shevapato2008/saiboard/conductor/index.md

# Project Context

## Definition
- [Product Definition](./product.md)
- [Product Guidelines](./product-guidelines.md)
- [Tech Stack](./tech-stack.md)

## Workflow
- [Workflow](./workflow.md)
- [Code Style Guides](./code_styleguides/)

## Management
- [Tracks Registry](./tracks.md)
- [Tracks Directory](./tracks/)
