shevapato2008/saiboard/conductor/tracks.md

# Project Tracks

This file tracks all major tracks for the project. Each track has its own detailed plan in its respective folder.

---

- [~] **Track: Phase 1 - Development Environment Setup and Hardware-Software Bridge Verification**
  *Link: [./tracks/setup_bridge_20260116/](./tracks/setup_bridge_20260116/)*
