shevapato2008/saiboard/docs/esp32-s3-led-matrix.md

# ESP32-S3 与 WS2812 矩阵接线与开发指南

## 1. ESP32-S3 介绍

### 1.1 组件说明（基于实物图）
- **ESP32-S3 模组（金属屏蔽罩）**：主控芯片，集成 Wi-Fi/BLE，负责运行固件与控制外设。
- **双 USB-C 接口**：
  - **USB-UART 口**：用于下载程序与串口日志（多数开发流程使用这个口）。
  - **USB-OTG 口**：用于原生 USB 功能（如 USB CDC/JTAG）。
- **BOOT / RST 按键**：
  - **BOOT**：进入下载模式（配合复位或自动下载时使用）。
  - **RST**：复位开发板。
- **USB 转串口芯片**：负责 USB 与 UART 通信转换。
- **电源与稳压电路**：将 5V 转换为 3.3V 供芯片使用。
- **排针**：提供电源与 GPIO 引脚引出。

### 1.1.1 背面插针定义与功能（以板上丝印为准）
你这块板子丝印清晰，建议以丝印为准对照。根据图片，排针分为上下两排：

- **上排（靠近 USB 口一侧）**：
  `GND, TX, RX, 1, 2, 42, 41, 40, 39, 38, 37, 36, 35, 0, 45, 48, 47, 21, 20, 19, GND, GND`

- **下排（靠近天线一侧）**：
  `3V3, 3V3, RST, 4, 5, 6, 7, 15, 16, 17, 18, 8, 3, 46, 9, 10, 11, 12, 13, 5Vin, GND`

功能分组说明：
- **电源**：`3V3`、`5Vin`、`GND`。
- **下载串口**：`TX`、`RX`（默认 UART0）。
- **复位**：`RST` 引脚。
- **GPIO**：数字编号的引脚为通用 GPIO，可用于 PWM、I2C、SPI 等。
- **启动相关引脚**：如 `GPIO0/BOOT`，上电时避免外接强上拉/下拉，防止进入错误启动模式。

### 1.2 ESP32-S3 开发环境搭建（ESP-IDF）
以下以 **ESP-IDF v5.5** 系列为例，步骤在不同系统大同小异。

#### Windows
1. 安装依赖：
   - Git（推荐 2.30+）
   - Python 3.10+（建议 3.11）
2. 安装官方 ESP-IDF Tools Installer（推荐）：
   - 下载并运行官方安装器。
   - 选择 ESP-IDF 版本并完成安装。
3. 打开 **ESP-IDF PowerShell** 或 **ESP-IDF CMD**。
4. 编译项目：
   ```bash
   cd <your_project>
   idf.py set-target esp32s3
   idf.py build
   idf.py -p COMx flash monitor
   ```

#### macOS
1. 安装依赖：
   ```bash
   brew install git cmake ninja python3
   ```
2. 拉取 ESP-IDF：
   ```bash
   git clone -b v5.5.2 --recursive https://github.com/espressif/esp-idf.git ~/esp-idf
   ```
3. 安装工具链与依赖：
   ```bash
   cd ~/esp-idf
   ./install.sh esp32s3
   ```
4. 设置环境变量：
   ```bash
   . ~/esp-idf/export.sh
   ```
   可把这行加入 `~/.zshrc` 方便长期使用。
5. 编译项目：
   ```bash
   cd <your_project>
   idf.py set-target esp32s3
   idf.py build
   ```

#### Linux (Ubuntu/Debian)
1. 安装依赖：
   ```bash
   sudo apt-get update
   sudo apt-get install -y git python3 python3-venv python3-pip cmake ninja-build ccache libffi-dev libssl-dev dfu-util
   ```
2. 拉取 ESP-IDF：
   ```bash
   git clone -b v5.5.2 --recursive https://github.com/espressif/esp-idf.git ~/esp-idf
   ```
3. 安装工具链与依赖：
   ```bash
   cd ~/esp-idf
   ./install.sh esp32s3
   ```
4. 设置环境变量：
   ```bash
   . ~/esp-idf/export.sh
   ```
5. 编译项目：
   ```bash
   cd <your_project>
   idf.py set-target esp32s3
   idf.py build
   ```

### 1.3 ESP32-S3 基础 GPIO 操作示例（C 语言）
下面示例演示 GPIO 输出（LED 闪烁）与输入（按键读取）。可放在 `main/main.c` 中：

```c
#include "freertos/FreeRTOS.h"
#include "freertos/task.h"
#include "driver/gpio.h"

#define LED_GPIO    GPIO_NUM_17
#define BTN_GPIO    GPIO_NUM_4

void app_main(void)
{
    // LED 输出
    gpio_config_t io_conf = {
        .pin_bit_mask = 1ULL << LED_GPIO,
        .mode = GPIO_MODE_OUTPUT,
        .pull_up_en = GPIO_PULLUP_DISABLE,
        .pull_down_en = GPIO_PULLDOWN_DISABLE,
        .intr_type = GPIO_INTR_DISABLE,
    };
    gpio_config(&io_conf);

    // 按键输入（内置上拉）
    gpio_config_t btn_conf = {
        .pin_bit_mask = 1ULL << BTN_GPIO,
        .mode = GPIO_MODE_INPUT,
        .pull_up_en = GPIO_PULLUP_ENABLE,
        .pull_down_en = GPIO_PULLDOWN_DISABLE,
        .intr_type = GPIO_INTR_DISABLE,
    };
    gpio_config(&btn_conf);

    while (1) {
        int btn = gpio_get_level(BTN_GPIO);
        gpio_set_level(LED_GPIO, btn == 0 ? 1 : 0); // 按下为低电平
        vTaskDelay(pdMS_TO_TICKS(200));
        gpio_set_level(LED_GPIO, 0);
        vTaskDelay(pdMS_TO_TICKS(200));
    }
}
```

> 建议使用非启动相关引脚（如 GPIO4/17/18），避免 GPIO0 在上电时影响启动模式。

## 2. LED 矩阵接口说明（基于实物图）
你提供的 8×8 WS2812 矩阵板有三组焊盘/插头：
- **DIN 端（数据输入）**：标有 `DIN`，用于接控制器数据线。
- **DOUT 端（数据输出）**：标有 `DOUT`，用于串联下一块矩阵。
- **5V/GND 电源端**：板上有多处 `5V`/`GND`，可用于电源注入或分流。

要点：
- 数据流向为 **DIN -> DOUT**。
- 单块矩阵只接 DIN 即可；多块串联时，前一块 DOUT 接后一块 DIN。

## 3. ESP32-S3 与 LED 矩阵连接方式（含供电建议）
根据官方连接图与实物接口，建议按如下方式接线：

### 3.1 接线步骤（单块矩阵）
1. **外部 5V 电源** → LED 矩阵 `5V`。
2. **外部电源 GND** → LED 矩阵 `GND`。
3. **外部电源 GND** 同时接到 ESP32-S3 的任意 `GND`（共地）。
4. **ESP32-S3 GPIO17** → LED 矩阵 `DIN`（数据输入）。
   - 项目默认固件使用 GPIO17：`LED_PIN_AT_5 GPIO_NUM_17`。

**视频讲解！**
(1) [How To Install WLED on an ESP32 Board and Connect / Control Addressable LEDs](https://www.youtube.com/watch?v=TOEnFKLm9Sw)
This video provides a comprehensive guide on how to install WLED on an ESP32 board and connect/control addressable LEDs.

The key steps covered are:
1. Installing WLED on ESP32 (0:00-1:20): The process begins by accessing install.wled.me in a web browser, plugging in the ESP32 board to a PC with a data-transfer-enabled micro USB cable, and clicking "install." The video also troubleshoots common issues like missing drivers. After installation, the video recommends configuring Wi-Fi preferences to a memorable address for easy access.
2. Wiring the ESP32 to LED Lights with Power Supplies (1:27-5:00): The tutorial demonstrates how to connect the ESP32 module to LED strips using color-coordinated wires (red for power, green for data, black for ground). It covers wiring with both large and medium power supplies, emphasizing the use of Wago connectors for easy and secure connections.
3. WLED App Setup and Basic Features (5:01-8:19): Once powered, the video guides users to download the WLED app, discover their controller, and configure LED preferences. This includes adjusting the automatic brightness limiter and selecting the correct LED strip type (e.g., WS2812). The video then showcases basic app features like turning lights on/off, adjusting brightness, changing colors, and applying various palettes and animation effects. It also demonstrates how to control animation speed.
4. Controlling LED Segments (8:20-9:13): Finally, the video explains how to use the "segments" feature to separate and control different portions of the LED strip independently, allowing for more complex lighting designs.

### 3.2 是否需要单独供电？
**需要。**ESP32-S3 开发板不适合给 WS2812 矩阵供电。
- WS2812 单颗最大约 **60mA**，8×8 共 64 颗，峰值约 **3.8A**。
- ESP32-S3 板载 5V（USB 供电）通常只有 0.5~1A 级别，远不足以稳定驱动。

因此建议：
- **矩阵单独用 5V 适配器供电**。
- ESP32 只提供数据信号，并与矩阵 **共地**。

### 3.3 稳定性建议
- 数据线串联 **330~470Ω 电阻**，减小反射干扰。
- 5V 与 GND 之间并联 **≥1000uF 电解电容**，吸收浪涌电流。
- 如出现闪烁/丢帧，可加 **电平转换器**（如 74AHCT125）。

### 3.4 多块矩阵串联
- 上一块 **DOUT** → 下一块 **DIN**。
- 电源建议多点注入，避免电压跌落导致颜色不一致。
