shevapato2008/saiboard/docs/hardware/pcb-tiling-diagram.html

# Saiboard PCB Tiling Diagram / 赛棋盘 PCB 拼接图

19x19 Go Board — 8 sub-boards 4×(8×8) + 2×(3×8) + 1×(11×3) + 1×(8×3) = 361

## Connection Details / 连接细节

### Detail A: 直接对插 (vertical)

### Detail B: 桥接 Bridge (horizontal)

### Detail C: 直接对插 (horizontal)

## Connector Reference / 连接器参考表

Board | Edge / 边 | J-Refs | Pins | Signal / 信号 | Connector Type | 中文
①②④⑤ 8x8 | Top / 上 | J21 | 2p | LED | ♂ SMD PinHeader | 卧贴排针
| | J2, J3, J4, J5 | 2p ea | Hall | ♂ SMD PinHeader | 卧贴排针
| Bottom / 下 | J20 | 2p | LED | ♀ SMD PinSocket | 卧贴排母
| | J6, J7, J8, J9 | 2p ea | Hall | ♀ SMD PinSocket | 卧贴排母
| Left / 左 | J18 | 3p | LED | ♀ SMD PinSocket | 卧贴排母
| | J10, J11, J12, J13 | 2p ea | PQ (Mux) | ♀ SMD PinSocket | 卧贴排母
| | J22 | 2p | Touch | ♀ SMD PinSocket | 卧贴排母
| Right / 右 | J19 | 3p | LED | ♀ SMD PinSocket | 卧贴排母
| | J14, J15, J16, J17 | 2p ea | PQ (Mux) | ♀ SMD PinSocket | 卧贴排母
| | J23 | 2p | Touch | ♀ SMD PinSocket | 卧贴排母
③ 8x3 | Left / 左 | J1 | 3p | LED | ♂ SMD PinHeader | 卧贴排针
| | J2, J3, J5, J6 | 2p ea | PQ (Mux) | ♂ SMD PinHeader | 卧贴排针
| | J4 | 2p | Touch | ♂ SMD PinHeader | 卧贴排针
| Right / 右 | J7 | 3p | LED | ♂ SMD PinHeader | 卧贴排针
| | J8, J9, J11, J12 | 2p ea | PQ (Mux) | ♂ SMD PinHeader | 卧贴排针
| | J10 | 2p | Touch | ♂ SMD PinHeader | 卧贴排针
| Bottom / 下 | J13(3p) J14(2p) J15(2p) J16(3p) J17(2p) J18(3p) J19(2p) | 17p total | Pwr, IC, Hall, Touch, LED | ♂ SMD PinHeader | 卧贴排针
⑥⑧ 3x8 | Top / 上 | J10(2p) J2(2p) J3(2p) J4(2p) J5(2p) | 10p | LED, Hall | ♂ SMD PinHeader | 卧贴排针
| Left / 左 | J12(3p), J16(3p) | 6p | PQ, LED | ♀ SMD PinSocket | 卧贴排母
| | J14(2p), J20(2p), J18(2p) | 6p | Touch, Hall, IC | ♀ SMD PinSocket | 卧贴排母
| Right / 右 | J13(3p), J17(3p) | 6p | PQ, LED | ♀ SMD PinSocket | 卧贴排母
| | J15(2p), J21(2p), J19(2p) | 6p | Touch, Hall, IC | ♀ SMD PinSocket | 卧贴排母
⑦ 11x3 | Top / 上 | J1(3p) J2(2p) J3(2p) J4(3p) J5(2p) J6(3p) J7(2p) | 17p | Pwr, IC, Hall, Touch | ♀ SMD PinSocket | 卧贴排母
| Left / 左 | J8(3p) J9-J13(2p ea) | 13p | Pwr, PQ, Touch | ♂ SMD PinHeader | 卧贴排针
| | J14-J18(2p ea) | 10p | PQ, Touch | ♂ SMD PinHeader | 卧贴排针
| Right / 右 | J19(3p) J20-J24(2p ea) | 13p | Pwr, PQ, Touch | ♂ SMD PinHeader | 卧贴排针
| | J25-J29(2p ea) | 10p | PQ, Touch | ♂ SMD PinHeader | 卧贴排针
| Internal / 内部 | J30, J31 (ESP32 2x22); J32, J33 (WAGO) | - | MCU, Power | Internal | 内部连接器

4×(8×8) + 2×(3×8) + 1×(11×3) + 1×(8×3) = 361 intersections

Saiboard PCB Tiling Diagram — 2026-02-10
