shevapato2008/saiboard/docs/hardware/electronics-bom.md

# PCB 物料清单 (BOM)

Saiboard 19×19 棋盘由 8 块 PCB 子板拼接而成：8x8 ×4、11x3 ×1、3x8 ×2、8x3 ×1。

BOM 源文件位于各子板的 `electronics/kicad_files/<board>/production/bom.csv`。

## 各子板物料清单

### 8x8 子板（×4 块）

| 元器件 | 值/型号 | 封装 | 数量 | PCB 面 | 作用 |
|---|---|---|---|---|---|
| SK6812 | RGB LED | PLCC4 5.0×5.0mm | 64 | F.Cu | 可寻址 RGB LED，提供视觉反馈 |
| AH49E | 霍尔传感器 | SOT-23 | 64 | F.Cu | 检测棋子磁铁的磁场方向和强度 |
| C104 | 100nF 电容 | 1206 | 64 | F.Cu | 每个 LED 旁的去耦电容，滤除电源噪声 |

连接器（均在 B.Cu）：Hall\_top ×4、Hall\_bottom ×4、PQ\_side\_a ×4、PQ\_side\_b ×4、LedIn\_side\_a ×1、LedIn\_side\_b ×1、LedIn\_top ×1、LedOut\_bottom ×1、Touch\_side\_a ×1、Touch\_side\_b ×1

### 11x3 子板（×1 块）— 主控板

| 元器件 | 值/型号 | 封装 | 数量 | PCB 面 | 作用 |
|---|---|---|---|---|---|
| SK6812 | RGB LED | PLCC4 5.0×5.0mm | 33 | F.Cu | 可寻址 RGB LED |
| AH49E | 霍尔传感器 | SOT-23 | 33 | F.Cu | 检测棋子磁铁 |
| C104 | 100nF 电容 | 1206 | 37 | F.Cu / B.Cu | 去耦电容（大部分在 F.Cu，IC 旁的在 B.Cu） |
| C106 | 10μF 电容 | 1206 | 2 | B.Cu | IC 电源滤波 |
| CP1 | 1000μF 电解电容 | 10×10.5mm | 1 | B.Cu | 大容量储能/电源稳压 |
| 2N3906 | PNP 三极管 | SOT-23 | 11 | B.Cu | 霍尔传感器行选通开关 |
| 330Ω | 电阻 | 1206 | 11 | B.Cu | 三极管基极限流 |
| 220Ω | 电阻 (RI1) | 1206 | 1 | B.Cu | LED 数据线串联电阻（信号整形） |
| 74HCT154D | 4-16 译码器 | SOP-24 | 1 | B.Cu | 19 行霍尔传感器的行选通控制 |
| AMS1117-3.3 | 3.3V 稳压器 | SOT-223 | 1 | B.Cu | 5V→3.3V，给 ESP32-S3 供电 |
| SN74LV1T34 | 电平转换器 | SOT-23-5 | 1 | B.Cu | 3.3V→5V 逻辑电平转换（LED 数据线） |

连接器（均在 B.Cu）：含 ESP32-S3 双排插座 ×2（2×22pin）、Wago 电源端子 ×2（总电源 + 树莓派供电）、以及各类板间信号连接器共 30 个。

### 3x8 子板（×2 块）

| 元器件 | 值/型号 | 封装 | 数量 | PCB 面 | 作用 |
|---|---|---|---|---|---|
| SK6812 | RGB LED | PLCC4 5.0×5.0mm | 24 | F.Cu | 可寻址 RGB LED |
| AH49E | 霍尔传感器 | SOT-23 | 24 | F.Cu | 检测棋子磁铁 |
| C104 | 100nF 电容 | 1206 | 25 | F.Cu | 去耦电容 |
| 74HC4052D | 双 4:1 模拟多路复用器 | SO-16 | 1 | B.Cu | 列方向霍尔信号多路选择 |

连接器（均在 B.Cu）：Hall\_top ×4、PQ\_side\_a ×1、PQ\_side\_b ×1、Touch ×2、LedIn ×1、LedOut ×2、IC ×2、Hall\_side ×2

### 8x3 子板（×1 块）

| 元器件 | 值/型号 | 封装 | 数量 | PCB 面 | 作用 |
|---|---|---|---|---|---|
| SK6812 | RGB LED | PLCC4 5.0×5.0mm | 24 | F.Cu | 可寻址 RGB LED |
| AH49E | 霍尔传感器 | SOT-23 | 24 | F.Cu | 检测棋子磁铁 |
| C104 | 100nF 电容 | 1206 | 27 | F.Cu / B.Cu | 去耦电容（大部分在 F.Cu，IC 旁的在 B.Cu） |
| C106 | 10μF 电容 | 1206 | 2 | B.Cu | IC 电源滤波 |
| 2N3906 | PNP 三极管 | SOT-23 | 8 | B.Cu | 霍尔传感器行选通开关 |
| 330Ω | 电阻 | 1206 | 8 | B.Cu | 三极管基极限流 |
| 74HCT138 | 3-8 译码器 | SO-16 | 1 | B.Cu | 8 行霍尔传感器的行选通控制 |
| AMS1117-3.3 | 3.3V 稳压器 | SOT-223 | 1 | B.Cu | 5V→3.3V 局部供电 |

连接器（均在 B.Cu）：PQ\_side\_a ×4、PQ\_side\_b ×4、Touch ×3、LedIn ×2、各类板间信号连接器共 18 个。

## 全板汇总（8 块子板合计，覆盖 19×19 = 361 交叉点）

| 元器件 | 8x8 ×4 | 11x3 ×1 | 3x8 ×2 | 8x3 ×1 | **总计** | PCB 面 | 作用与必要性 |
|---|---|---|---|---|---|---|---|
| SK6812 LED | 256 | 33 | 48 | 24 | **361** | F.Cu | 每个交叉点一颗可寻址 RGB LED。通过单线串联（DIN→DOUT 级联），ESP32 可独立控制每颗 LED 的颜色和亮度。用于显示 AI 推荐落点、标记最后一手、显示形势判断热力图等视觉反馈。361 颗对应 19×19 交叉点，缺一不可。 |
| AH49E 霍尔传感器 | 256 | 33 | 48 | 24 | **361** | F.Cu | 线性霍尔效应传感器，每个交叉点一颗。输出电压与磁场强度成正比：无棋子时输出约中间电压，黑子磁铁（N 极朝上）输出正偏移，白子磁铁（S 极朝上）输出负偏移。据此区分空位/黑子/白子三种状态。361 颗对应 19×19，是棋盘感知的核心。 |
| 100nF 电容 (C104) | 256 | 37 | 50 | 27 | **370** | F.Cu / B.Cu | SK6812 内部有高频开关电路（PWM 驱动 RGB），会在电源线上产生高频噪声。每颗 LED 旁紧贴一个 100nF 去耦电容，就近滤除电源毛刺，防止噪声串扰到相邻 Hall 传感器的模拟读数。数据手册要求每颗 LED 配一个，少了会导致 LED 闪烁或 Hall 读数不稳。LED 旁的在 F.Cu，IC 旁的在 B.Cu。 |
| 10μF 电容 (C106) | 0 | 2 | 0 | 2 | **4** | B.Cu | 译码器（74HCT154D/74HCT138）和稳压器（AMS1117）的电源去耦。100nF 滤高频，10μF 滤中低频纹波，两者配合使用。IC 正常工作的基本要求。 |
| 1000μF 电解电容 | 0 | 1 | 0 | 0 | **1** | B.Cu | 位于 11x3 主控板的总电源入口处。361 颗 SK6812 全亮白光时峰值电流可达 ~7A（每颗约 20mA×3），瞬间大电流切换会导致电源电压跌落。大容量电解电容作为储能缓冲，吸收瞬态电流冲击，稳定 5V 总线。没有它，大面积 LED 同时亮起时可能导致电压不稳、ESP32 重启。 |
| 2N3906 PNP 三极管 | 0 | 11 | 0 | 8 | **19** | B.Cu | 霍尔传感器矩阵的行选通开关。361 个传感器不可能各占一个 GPIO，所以按行列矩阵扫描：译码器选中某一行时，对应 PNP 三极管导通，给该行的所有 Hall 传感器供电（VCC）；未选中的行断电，不输出信号。ESP32 逐行扫描，每次只读一行。19 行对应 19 个三极管，是矩阵扫描的核心。 |
| 330Ω 电阻 | 0 | 11+1 | 0 | 8 | **20** | B.Cu | 三极管基极限流电阻。译码器输出低电平时通过电阻驱动 PNP 三极管导通，电阻限制基极电流在安全范围内（约 10mA），防止烧毁译码器输出级或三极管。11x3 上多的 1 颗 220Ω (RI1) 是 LED 数据线的串联电阻，匹配阻抗、减少信号反射振铃，SK6812 数据手册推荐。 |
| 74HCT154D 4-16 译码器 | 0 | 1 | 0 | 0 | **1** | B.Cu | 位于 11x3 主控板。ESP32 用 4 根地址线（A0-A3）选择 16 行中的一行，译码器将其转换为 16 根独立输出线，每次只有一根为低电平（激活对应 PNP 三极管）。配合 8x3 板上的 74HCT138 共同覆盖 19 行扫描。用 4 根 GPIO 控制 16 行，大幅节省引脚资源。 |
| 74HCT138 3-8 译码器 | 0 | 0 | 0 | 1 | **1** | B.Cu | 位于 8x3 板。原理同上，用 3 根地址线选择 8 行中的一行。与 74HCT154D 互补，两者合计可寻址所有 19 行（实际 16+8=24，有冗余）。覆盖 8x3 板负责的那部分行。 |
| 74HC4052D 双 4:1 模拟 MUX | 0 | 0 | 2 | 0 | **2** | B.Cu | 位于两块 3x8 板上。霍尔传感器输出的是模拟电压，不能用数字译码器选择，需要模拟多路复用器。每颗 4052 内含两个 4 选 1 模拟开关，将该板上多列 Hall 输出汇聚到少数几根模拟信号线上，送回主板给 ESP32 的 ADC 读取。列方向的模拟信号选择，矩阵扫描的另一半。 |
| AMS1117-3.3 稳压器 | 0 | 1 | 0 | 1 | **2** | B.Cu | 线性稳压器，5V→3.3V。ESP32-S3 工作电压为 3.3V，而系统总线是 5V。11x3 主控板的那颗给 ESP32 供电；8x3 板的那颗给本板上的 74HCT138 等 3.3V 逻辑芯片供电。电压不匹配，必须有稳压转换。 |
| SN74LV1T34 电平转换器 | 0 | 1 | 0 | 0 | **1** | B.Cu | 单比特电压电平转换器。ESP32 的 GPIO 输出 3.3V 逻辑电平，但 SK6812 数据线要求高电平 ≥ 0.7×VDD = 3.5V（5V 供电时）。3.3V 低于此阈值，直接连接会导致 LED 通信不稳定。此芯片将 3.3V 数据信号转换为 5V 电平。只需一颗（在数据链起点），之后 LED 串联传递就都是 5V 电平了。 |
