shevapato2008/saiboard/docs/hardware/guide.md

# Saiboard 硬件开发与生产指南

本指南旨在帮助开发者了解 Saiboard 项目中的工业生产模型，掌握相关软件工具的使用，并指导如何将设计转化为实物。

## 1. 硬件模型概览与背景知识

项目中的硬件设计分为三个核心部分：

### 1.1 棋盘结构 (Board Structure)
*   **模型位置**: `board/cnc_files/`（CNC/激光切割文件）, `board/3d_prints/`（辅助工具）
*   **文件格式**: `.f3d` (Fusion 360 源文件), `.dxf` (2D 矢量，直接发给加工厂)
*   **参考图片**: `board/board.jpg`（组装实物照片）
*   **背景知识**:
    *   **木工与 CNC**: 棋盘框架由胶合板加工而成。`.dxf` 文件用于激光切割或 CNC 铣削。
    *   **公差 (Tolerance)**: 硬件设计中必须考虑零件组装时的间隙，否则无法物理嵌入。
    *   **层叠结构**: 棋盘由 4 层木板叠合，形成空腔容纳电子元件（详见 4.1 节）。
*   **软件**: **Autodesk Fusion 360**（编辑 `.f3d`）, **AutoCAD / Inkscape**（查看 `.dxf`）。
*   **作用**: 定义棋盘的物理外观、尺寸、传感器排布以及各部件的连接方式。

#### 文件清单

| 文件路径 | 说明 |
| :--- | :--- |
| `board/cnc_files/Top.f3d` / `top.dxf` | 顶层面板（6.5mm 胶合板），含 361 个 LED 透光孔 |
| `board/cnc_files/grid.f3d` / `grid.dxf` | 网格层（6.5mm 胶合板），LED 对准孔，透光显示网格线 |
| `board/cnc_files/side.f3d` / `side.dxf` | 侧框（10mm 胶合板），四周围框形成内部空腔 |
| `board/cnc_files/bottom.f3d` / `bottom.dxf` | 底板（5mm 胶合板），结构底板 |
| `board/3d_prints/pen_part1.f3d` | CNC 弹簧笔架 Part 1（用于绘制棋盘网格线） |
| `board/3d_prints/pen_part2.f3d` | CNC 弹簧笔架 Part 2 |

#### 所需材料

| 材料 | 规格 | 备注 |
| :--- | :--- | :--- |
| 胶合板 (Plywood) | 6.5mm（顶层 + 网格层各 1 块）, 10mm（侧框 1 块）, 5mm（底板 1 块） | 按 `.dxf` 文件尺寸裁切 |
| 木皮 (Veneer) | 0.6mm 厚，面积略大于顶层面板 | 贴合在顶层表面，遮盖 LED 孔 |
| 木工胶 (Wood Glue) | [Titebond](https://www.amazon.de/Titebond-Classic-Holzleim-118-506/dp/B0044UKJ62) 或同级别 | 粘合各层木板和木皮 |
| 透明环氧树脂 | 双组份透明环氧 | 从内侧灌入 LED 孔，保护 LED 并增强结构 |
| 擦涂式聚氨酯漆 (Wipe-on Poly) | 油性或水性均可，如 [Minwax Wipe-on Poly](https://www.amazon.de/Minwax-polycryl-40910-wipe-%C3%96l-basierende-1-pint/dp/B01MU1VFWV) | 表面保护，至少 4 层 |
| 针管笔 (Technical Pen) | [rOtring Isograph 0.8mm](https://www.amazon.de/rOtring-isograph-Tuschef%C3%BCller-0-8/dp/B000USK8KY) 或同类 | 绘制棋盘网格线 |
| 弹簧 | 配合 3D 打印笔架使用 | 用于 CNC 弹簧笔架组装，参考[弹簧笔架教程](https://www.instructables.com/Spring-loaded-CNC-Penholder-for-Rapidograph-techni/) |

#### 木皮选材建议

木皮贴在顶层面板上方，LED 灯光需要透过木皮漫射出来，因此**透光性**是选材的核心考量。推荐选择浅色、纹理均匀的树种：

| 树种 | 优点 | 缺点 |
| :--- | :--- | :--- |
| 榧木 (Kaya) | 围棋盘传统用材，色泽温润，纹理细腻 | 价格极高 |
| 新榧 / 云杉 (Shin-Kaya / Spruce) | 颜色与榧木接近，浅黄色，透光性好，价格合理 | 纹理相对普通 |
| 桧木 (Hinoki) | 日式棋盘常用，颜色浅，质地均匀 | 有些品种纹理不够直 |
| 枫木 (Maple) | 颜色浅白，纹理均匀，透光效果好，易获取 | 非传统围棋盘用材 |
| 桦木 (Birch) | 浅色，纹理细密，0.6mm 时透光性好 | 非传统围棋盘用材 |

> **不推荐：** 胡桃木、黑檀等深色木材会严重阻挡 LED 光线；橡木等导管粗大的木材透光不均匀，且针管笔画线时墨水容易沿导管渗开。

> **建议：** 综合透光性、外观和性价比，**新榧（云杉类）或枫木**是较优选择。购买前建议先取一小块样品测试 LED 透光效果。

#### 制作步骤

**第一阶段：CNC / 激光切割**

1. 将 4 个 `.dxf` 文件（`top.dxf`, `grid.dxf`, `side.dxf`, `bottom.dxf`）发给加工厂或导入自有 CNC/激光设备。
2. **务必确认单位为毫米 (mm)**，防止比例缩放错误。
3. 按对应板厚裁切：顶层和网格层 6.5mm、侧框 10mm、底板 5mm。
4. 告知加工师傅区分"切断"和"雕刻"（如果有浅雕线条）。

**第二阶段：木框粘合**

1. 将 **底板**、**侧框**、**网格层** 三层对齐叠放，用木工胶粘合。
2. 使用木工夹夹紧，**静置过夜**等胶水完全固化。
3. 打磨接合面，确保各层平整无错位。

> **注意：** 此阶段**不粘顶层面板**，因为需要先安装电子元件（见 4.2 节步骤三），最后再盖上顶层。

**第三阶段：顶层面板处理**

1. 裁切一块 0.6mm 木皮，面积略大于顶层面板。
2. 在面板表面和木皮背面各涂一层木工胶，**晾至半干**（不粘手但有粘性）。
3. 将木皮覆盖到面板上，用熨斗加热压实，使胶水重新活化并牢固粘合。
4. 待冷却后，用刀片或砂纸修剪木皮至与面板齐平。
5. （可选）轻涂一层木蜡油（Oil finish）作为初步保护。

**第四阶段：灌注树脂**

1. 将木框（底板+侧框+网格层）翻转，使 LED 孔朝上。
2. 从**内侧**向 361 个 LED 孔灌入透明环氧树脂，覆盖孔洞即可。
3. 用喷枪消除气泡，静置固化（24 小时）。
4. 树脂固化后，LED 光线将通过木皮漫射，形成柔和的透光效果。

**第五阶段：表面涂装**

1. 在顶层面板表面涂刷第 1 层**聚氨酯漆**（擦涂式 Wipe-on Poly），薄涂均匀。
2. 干燥后用 320 目砂纸轻磨，擦净粉尘。
3. 重复涂刷共 **4 层**（每层之间轻磨）。
4. 最终表面应光滑、有轻微光泽、具备防水防污能力。

**第六阶段：绘制棋盘网格线**

1. 组装 CNC 弹簧笔架：3D 打印 `pen_part1.f3d` 和 `pen_part2.f3d`，配合弹簧组装（参考 [Instructables 弹簧笔架教程](https://www.instructables.com/Spring-loaded-CNC-Penholder-for-Rapidograph-techni/)）。
2. 将 rOtring Isograph 0.8mm 针管笔装入笔架，安装到 CNC 机器上。
3. 用 CNC 自动绘制 19×19 网格线（直线部分）。
4. **星位 (Star Points)** 需手工点绘——标准 19×19 棋盘有 9 个星位。
5. 网格线完成后，再涂刷 1-2 层聚氨酯漆封住墨线，防止磨损。

> **提示：** 如果没有 CNC 设备，也可以用直尺和针管笔手工绘制网格线，但需要极高的精度和耐心。

### 1.2 电子系统 (Electronics)
*   **模型位置**: `electronics/kicad_files/`, `electronics/3d_prints/`
*   **文件格式**: `.kicad_sch` / `.kicad_pcb` (KiCad), `.f3d`
*   **背景知识**:
    *   **PCB 设计**: 涉及电路原理图和印刷电路板布线。
    *   **霍尔传感器 (Hall Effect Sensor)**: 项目核心硬件，用于通过磁性检测棋子位置。
    *   **3D 打印遮罩**: 用于辅助固定传感器或遮挡光线。
*   **软件**: **KiCad**, **Fusion 360**。
*   **作用**: KiCad 负责电路逻辑和 PCB 生产；Fusion 360 负责设计 PCB 的支撑结构和外壳。

#### PCB 子板拼接布局 (19×19 Matrix Tiling)

完整的 19×19 传感器/LED 矩阵由 **8 块 PCB 子板**拼接而成（19 = 8 + 8 + 3）。

> 📐 **交互式高清示意图**：[pcb-tiling-diagram.html](pcb-tiling-diagram.html)（浏览器打开，包含连接器颜色编码、信号标注和拼接方式图解）

文本版布局如下：

```
         列1──────8  列9─────16  列17─19
        ┌─────────┬──────────┬────────┐
        │         │          │        │
 行     │  8 × 8  │  8 × 8   │ 3 × 8  │
 1      │  (64)   │  (64)    │ (24)   │
 ↓      │         │          │        │
 8      │   ①     │   ②      │  ③     │
        ├─────────┼──────────┼────────┤
        │         │          │        │
 行     │  8 × 8  │  8 × 8   │ 3 × 8  │
 9      │  (64)   │  (64)    │ (24)   │
 ↓      │         │          │        │
 16     │   ④     │   ⑤      │  ⑥     │
        ├─────────┴──────────┼────────┤
 行     │                    │        │
 17     │     11 × 3         │ 8 × 3  │
 ↓      │     (33)           │ (24)   │
 19     │       ⑦            │  ⑧     │
        └────────────────────┴────────┘
```

| 型号 | 数量 | 每板传感器/LED | 小计 | KiCad 项目路径 |
| :--- | :--- | :--- | :--- | :--- |
| 8×8 | 4 | 64 | 256 | `electronics/kicad_files/8x8/` |
| 3×8 | 2 | 24 | 48 | `electronics/kicad_files/3x8/` |
| 11×3 | 1 | 33 | 33 | `electronics/kicad_files/11x3/` |
| 8×3 | 1 | 24 | 24 | `electronics/kicad_files/8x3/` |
| **合计** | **8 块** | | **361** | |

*   ⑦号 11×3 板横跨列1-11（覆盖了左下角区域），避免了需要一块独立的 3×3 小板。
*   各子板通过排针/排母连接器（PQ、Hall、LED、Touch、Power）互联。

#### 子板边缘连接器详解

每块子板（以 8×8 为例）的四条边分布着不同类型的连接器，所有连接器均为 **2.54mm 间距卧贴 SMD** 封装：

| 边 | 连接器类型 | 数量与规格 | 传递信号 |
| :--- | :--- | :--- | :--- |
| **上边 (Top)** | 公头 (PinHeader) | 1×02 × 4 组 + 1×02 × 1 | Hall 输出 (HallOut1-8) + LED 数据输入 |
| **下边 (Bottom)** | 母头 (PinSocket) | 1×02 × 4 组 + 1×02 × 1 | Hall 输入 + LED 数据输出 |
| **左边 (Left)** | 母头 (PinSocket) | 1×02 × 4 + 1×03 × 1 + 1×02 × 1 | PQ 信号 + LED (5V/Data/GND) + Touch |
| **右边 (Right)** | 母头 (PinSocket) | 1×02 × 4 + 1×03 × 1 + 1×02 × 1 | PQ 信号 + LED (5V/Data/GND) + Touch |

#### 拼接方式

**上下拼接（直接对插）：** 上方板的下边母头与下方板的上边公头直接插接，无需额外部件。

```
  板①下边 ♀♀♀♀♀ (PinSocket/母头)
           ↕ 直接对插
  板④上边 ♂♂♂♂♂ (PinHeader/公头)
```

**左右拼接（桥接件）：** 相邻板的左右两边均为母头，需要用一小截**双头公针**（直排针）作为桥接件插入两侧母头。

```
  板①右边 ♀♀ (母头) ──[1×02 直排针]── ♀♀ (母头) 板②左边
  板①右边 ♀♀♀(母头) ──[1×03 直排针]── ♀♀♀(母头) 板②左边
```

#### 连接器安装示意图

```
         列1──────8    列9─────16    列17─19
        ┌──────────┬───────────┬─────────┐
        │ ♂♂♂♂♂    │ ♂♂♂♂♂     │ ♂♂♂♂♂   │  ← 顶边公头
   ♀♀  │          ♀♀♀         ♀♀♀        │ ♀♀
   ♀♀  │    ①    桥接    ②   桥接   ③   │ ♀♀
   ♀♀  │          ♀♀♀         ♀♀♀        │ ♀♀
        │ ♀♀♀♀♀    │ ♀♀♀♀♀     │ ♀♀♀♀♀   │  ← 底边母头
        ├───↕──────┼────↕──────┼───↕─────┤
        │ ♂♂♂♂♂    │ ♂♂♂♂♂     │ ♂♂♂♂♂   │  ← 顶边公头
   ♀♀  │          ♀♀♀         ♀♀♀        │ ♀♀
   ♀♀  │    ④    桥接    ⑤   桥接   ⑥   │ ♀♀
   ♀♀  │          ♀♀♀         ♀♀♀        │ ♀♀
        │ ♀♀♀♀♀    │ ♀♀♀♀♀     │ ♀♀♀♀♀   │
        ├───↕──────┴────↕──────┼───↕─────┤
        │ ♂♂♂♂♂♂♂♂♂♂♂          ♀♀♀       │
        │       ⑦              桥接  ⑧   │
        │     11 × 3           │ 8 × 3   │
        └──────────────────────┴─────────┘

♂ = 公头 (PinHeader)     ♀ = 母头 (PinSocket)
↕ = 上下直接对插（公头插入母头）
桥接 = ♀母头──[双头公针]──母头♀
```

#### 连接器采购清单

所有连接器均为 **2.54mm 间距**、卧贴（Horizontal SMD）安装。建议购买 1×40P 长条自行掰断至所需长度。

> **注意：** 连接器在嘉立创 SMT 下单时标记为"不贴的元件"，需收到 PCB 后自行手工焊接。焊接难度低（焊盘大、间距宽），适合新手。

##### 8×8 子板（每板 22 个，共 4 板：①②④⑤）

| 边 | 类型 | 规格 | 数量 | 参考编号 | 信号 |
| :--- | :--- | :--- | :---: | :--- | :--- |
| 上 | 排针 ♂ | 1×02 | 4 | J2–J5 | Hall_top |
| 上 | 排针 ♂ | 1×02 | 1 | J21 | LedIn_top |
| 下 | 排母 ♀ | 1×02 | 4 | J6–J9 | Hall_bottom |
| 下 | 排母 ♀ | 1×02 | 1 | J20 | LedOut_bottom |
| 左 | 排母 ♀ | 1×02 | 4 | J10–J13 | PQ_side_a |
| 左 | 排母 ♀ | 1×02 | 1 | J22 | Touch_side_a |
| 左 | 排母 ♀ | 1×03 | 1 | J18 | LedIn_side_a |
| 右 | 排母 ♀ | 1×02 | 4 | J14–J17 | PQ_side_b |
| 右 | 排母 ♀ | 1×02 | 1 | J23 | Touch_side_b |
| 右 | 排母 ♀ | 1×03 | 1 | J19 | LedIn_side_b |

小计：排针 1×02 ×5 ＋ 排母 1×02 ×15 ＋ 排母 1×03 ×2 = **22 个/板**

##### 3×8 子板（每板 15 个，共 2 板：③⑥）

| 边 | 类型 | 规格 | 数量 | 参考编号 | 信号 |
| :--- | :--- | :--- | :---: | :--- | :--- |
| 上 | 排针 ♂ | 1×02 | 4 | J2–J5 | Hall_top |
| 上 | 排针 ♂ | 1×02 | 1 | J10 | LedIn |
| 左 | 排母 ♀ | 1×02 | 1 | J14 | Touch_side_a |
| 左 | 排母 ♀ | 1×02 | 1 | J18 | IC_side_a |
| 左 | 排母 ♀ | 1×02 | 1 | J20 | Hall_side_a |
| 左 | 排母 ♀ | 1×03 | 1 | J12 | PQ_side_a |
| 左 | 排母 ♀ | 1×03 | 1 | J16 | LedOut_side_a |
| 右 | 排母 ♀ | 1×02 | 1 | J15 | Touch_side_b |
| 右 | 排母 ♀ | 1×02 | 1 | J19 | IC_side_b |
| 右 | 排母 ♀ | 1×02 | 1 | J21 | Hall_side_b |
| 右 | 排母 ♀ | 1×03 | 1 | J13 | PQ_side_b |
| 右 | 排母 ♀ | 1×03 | 1 | J17 | LedOut_side_b |

小计：排针 1×02 ×5 ＋ 排母 1×02 ×6 ＋ 排母 1×03 ×4 = **15 个/板**

##### 8×3 子板（每板 19 个，共 1 板：⑧）— 全部为排针

| 边 | 类型 | 规格 | 数量 | 参考编号 | 信号 |
| :--- | :--- | :--- | :---: | :--- | :--- |
| 左 | 排针 ♂ | 1×02 | 5 | J2–J6 | PQ_side_a (×3), Touch, PQ |
| 左 | 排针 ♂ | 1×03 | 1 | J1 | LedIn_side_a |
| 右 | 排针 ♂ | 1×02 | 5 | J8–J12 | PQ_side_b (×3), Touch, PQ |
| 右 | 排针 ♂ | 1×03 | 1 | J7 | LedIn_side_b |
| 下 | 排针 ♂ | 1×02 | 4 | J14, J15, J17, J19 | IC (×2), Touch, Conn |
| 下 | 排针 ♂ | 1×03 | 3 | J13, J16, J18 | Conn, Hall, Led |

小计：排针 1×02 ×14 ＋ 排针 1×03 ×5 = **19 个/板**

##### 11×3 子板（每板 33 个，共 1 板：⑦）

| 边 | 类型 | 规格 | 数量 | 参考编号 | 信号 |
| :--- | :--- | :--- | :---: | :--- | :--- |
| 上 | 排母 ♀ | 1×02 | 4 | J2, J3, J5, J7 | IC (×2), Touch, Power |
| 上 | 排母 ♀ | 1×03 | 3 | J1, J4, J6 | Power, Hall, Power |
| 左 | 排针 ♂ | 1×02 | 5 | J9–J13 | PQ (×4), Touch |
| 左 | 排针 ♂ | 1×03 | 1 | J8 | Power_side_a |
| 右 | 排针 ♂ | 1×02 | 5 | J20–J24 | PQ (×4), Touch |
| 右 | 排针 ♂ | 1×03 | 1 | J19 | Power_side_b |
| 下 | 排针 ♂ | 1×02 | 6 | J14, J16, J17, J25, J27, J28 | Touch/Hall/IC (左右各 3) |
| 下 | 排针 ♂ | 1×03 | 4 | J15, J18, J26, J29 | PQ/Power (左右各 2) |
| — | 排母 ♀ | 2×22 竖直 | 2 | J30, J31 | ESP32-S3 插座 |
| — | Wago 端子 | 2P | 2 | J32, J33 | 电源/树莓派 |

小计：排针 1×02 ×16 ＋ 排针 1×03 ×6 ＋ 排母 1×02 ×4 ＋ 排母 1×03 ×3 ＋ 排母 2×22 ×2 ＋ Wago ×2 = **33 个/板**

##### 板间桥接件（直插双头公针）

用于左右水平拼接——两侧均为排母（♀）时，用双头公针作为桥接件（♀──[♂♂]──♀）：

| 桥接位置 | 1×02 数量 | 1×03 数量 | 小计 |
| :--- | :---: | :---: | :---: |
| ①↔② (8×8 ↔ 8×8) | 5 | 1 | 6 |
| ④↔⑤ (8×8 ↔ 8×8) | 5 | 1 | 6 |
| ⑦↔⑧ (11×3 ↔ 8×3) | 3 | 2 | 5 |
| **合计** | **13** | **4** | **17** |

> ②↔③ 和 ⑤↔⑥ 的桥接件数量取决于设计修复后的连接器布局，参见下方「已知设计问题」。

##### 总采购汇总（满板 19×19）

按 4×8×8 + 2×3×8 + 1×8×3 + 1×11×3 拼接计算：

| 物料 | 规格 | 用途 | 数量 |
| :--- | :--- | :--- | :---: |
| 卧贴排针 (SMD PinHeader) | 1×02 | 板上焊接 | 60 |
| 卧贴排针 (SMD PinHeader) | 1×03 | 板上焊接 | 11 |
| 卧贴排母 (SMD PinSocket) | 1×02 | 板上焊接 | 76 |
| 卧贴排母 (SMD PinSocket) | 1×03 | 板上焊接 | 19 |
| 卧贴排母 (SMD PinSocket) | 2×22 竖直 | ESP32-S3 插座 | 2 |
| Wago 弹簧端子 | 2601-602 (2P) | 电源连接 | 2 |
| 直插排针 (Through-hole) | 1×02 双头 | 板间桥接 | 13 |
| 直插排针 (Through-hole) | 1×03 双头 | 板间桥接 | 4 |
| **总计** | | | **187** |

> 建议额外采购 10–15% 作为备用。

#### 已知设计问题

在验证 KiCad 文件中各子板边缘连接器的兼容性时，发现以下问题需要在生产完整 19×19 棋盘前解决。**8×8 单板试产不受影响。**

> 📐 **修复方案示意图**：同一页面下方（[pcb-tiling-diagram.html](pcb-tiling-diagram.html) Part 2），紫色高亮标注所有需修改的部分。

| # | 严重程度 | 问题描述 | 涉及板 | 解决方案 |
| :--- | :--- | :--- | :--- | :--- |
| 1 | **严重** | 11×3 子板（⑦号）KiCad 文件中**未定义任何边缘连接器** | `11x3/` | 在 KiCad 中添加连接器（参考 8×8 板的设计） |
| 2 | **严重** | 左右水平拼接时，两侧均为母头（PinSocket），无法直接对插 | 所有板的左/右边 | 设计意图为使用直排针桥接件（已在拼接方式中说明），需验证物理间距是否匹配 |
| 3 | **中等** | 8×3 子板（⑧号）所有边缘均为公头（PinHeader），与相邻板的连接方式需确认 | `8x3/` | 核查原理图，确认是否需要修改为与其他板一致的公母搭配 |

### 1.3 棋子与模具 (Stones & Molds)
*   **模型位置**: `stones/3d_prints/`
*   **文件格式**: `.f3d` (Fusion 360), `.gcode` (预切片打印文件)
*   **参考图片**: `stones/mold.jpeg`（模具）, `stones/stones.jpg`（成品棋子）
*   **背景知识**:
    *   **翻模灌浆**: 棋子是通过 3D 打印阳模 → 浇注硅胶阴模 → 灌注树脂的三步工艺制作的。
    *   **阳模与阴模的关系**:
        *   **阳模**（3D 打印件）= 棋子形状的"凸"模板，用来制作阴模，之后就不再需要。
        *   **阴模**（硅胶模具）= 实际浇铸用的"凹"模具，往凹坑里放磁铁、倒树脂即可生产棋子。
        *   为什么不直接 3D 打印凹模？因为硬塑料模具脱模困难（树脂会粘死），而硅胶柔软有弹性，掰一下棋子就弹出来，且可重复使用几百次。
        *   流程：`3D打印阳模（凸）→ 浇硅胶 → 硅胶阴模（凹）→ 浇树脂+磁铁 → 成品棋子`
    *   **磁铁嵌入**: 每颗棋子内埋一块钕磁铁（装在镀锌六角螺母中），用于霍尔传感器检测。
    *   **黑白区分**: 黑子和白子的磁铁**极性相反**，传感器通过正/负磁场区分颜色。
*   **软件**: **Fusion 360**, **切片软件 (PrusaSlicer/Bambu Studio)**。
*   **作用**: 设计棋子的形态以及用于批量生产棋子的模具。

#### 文件格式说明：STL vs G-code

| 格式 | 含义 | 类比 | 打开软件 |
| :--- | :--- | :--- | :--- |
| `.f3d` | Fusion 360 源文件，可导出 STL/STEP | 原始设计稿 | Fusion 360 |
| `.stl` | 3D 模型的形状描述（三角面片网格），与打印机无关 | 建筑设计图纸 | Fusion 360、PrusaSlicer、Bambu Studio、Cura、Windows 3D Viewer |
| `.gcode` | 打印机的逐行执行指令（喷头路径、温度、挤出量），针对**特定打印机和参数**生成 | 施工队的逐步施工指令 | PrusaSlicer、Bambu Studio、Cura（预览路径）；或直接发送给打印机 |

转换流程：`.f3d` → 导出 `.stl` → 切片软件 → `.gcode` → 打印机执行

| 场景 | 用哪个文件 |
| :--- | :--- |
| 你有 Prusa MK3S 打印机 | 直接用 `.gcode`，无需任何软件处理 |
| 你有其他型号打印机 | 用 `.f3d` 导出 STL，再用你打印机对应的切片软件生成 G-code |
| 发给代工厂打印 | 用 `.f3d` 导出 STL 发给厂商，厂商会用自己的切片软件处理 |

**从 Fusion 360 导出 STL 的步骤：**

1. 在左侧 BROWSER 面板中展开 **Bodies**，选中要导出的实体（如 `Body1`）。
2. 右键点击 → 选择 **Save As Mesh**（新版 Fusion 中此选项等同于导出 STL）。
3. 在弹出对话框中设置：
    *   **Format**: `STL (Binary)`（文件更小）
    *   **Refinement**: `High`（面片更细腻，打印效果更好）
4. 点击 **Save**，选择保存位置。

> 备选方式：顶部菜单 **File → Export** → Format 下拉选 **STL Files (*.stl)** → Save。

#### 文件清单

| 文件 | 说明 |
| :--- | :--- |
| `stones/3d_prints/go_stones_mold.f3d` | 棋子阳模 3D 源文件 (Fusion 360)，发给代工厂时导出 STL |
| `stones/3d_prints/go_stones_mold_0.05mm_PETG_MK3S_1d1h55m.gcode` | 阳模预切片 G-code（0.05mm 层高，PETG，Prusa MK3S，约 46 小时），仅适用于 Prusa MK3S |
| `stones/3d_prints/stone_holder.f3d` | 打磨辅助夹具 3D 源文件 |
| `stones/3d_prints/stone_holder_0.2mm_PETG_MK3S_2h27m.gcode` | 夹具预切片 G-code（0.2mm 层高，约 2.5 小时），仅适用于 Prusa MK3S |

#### 所需材料

| 材料 | 规格 | 用量 | 备注 |
| :--- | :--- | :--- | :--- |
| 环氧树脂 (Epoxidharz) | 双组份透明环氧 | 每颗棋子约 1.6 ml | 白子用原色，黑子加色浆 |
| 色浆 (Color Paste) | 黑色 RAL 9005 | 树脂重量的 5% | 仅黑子需要 |
| 硅橡胶 (Silicone) | 翻模用硅胶（如 Wagnersil Premium **[原始]**），建议邵氏硬度 20A、1:1 配比 **[建议]** | 约 130g / 整副模具 **[原始]** | 用于制作阴模 |
| 钕磁铁 | 7×4 mm，N35 级，圆柱形，镀镍 | 361 颗 + 备用 | 黑白子各约 181 颗。[淘宝参考链接](https://item.taobao.com/item.htm?id=672956098069)，下单时选 **直径 7mm × 厚度 4mm** |
| 镀锌六角螺母 | DIN 439 BM 8×1，碳钢蓝白锌 | 同磁铁数量 | **必须镀锌碳钢**（不可用不锈钢），屏蔽磁场防止相邻棋子互相干扰。[淘宝参考链接](https://item.taobao.com/item.htm?id=43489232452)，下单时选 **M8，螺距1.0（细牙）** |
| 底漆/填充剂 (Primer/Filler) | 塑料表面底漆喷罐 | 1 罐 | 阳模表面处理用 |
| 异丙醇 (Isopropanol) | 工业级 | 少量 | 清洁黑子表面 |
| 抛光油 | 矿物油或护理油 | 少量 | 黑子最终抛光 |

#### 制作步骤

> 以下步骤中，来自 `stones/README.md` 原始项目文件的内容标注为 **[原始]**，编者补充的操作细节标注为 **[建议]**。

**第一阶段：3D 打印阳模**

1. 用 Fusion 360 打开 `go_stones_mold.f3d`，或直接使用预切片的 `.gcode` 文件。
2. **打印参数**：材料 PETG **[原始]**，层高 **0.05mm** **[原始]**，填充率 15-20% **[建议]**。
3. 打印完成后打磨表面 **[原始：sand it]**。建议用细砂纸（400→800→1200 目）逐级打磨 **[建议]**。
4. 喷涂 **底漆/填充剂**（Primer/Filler），填平 3D 打印层纹，使表面光滑 **[原始]**。
5. 干燥后再次轻磨至满意的光洁度——阳模的表面质量直接决定棋子的最终手感 **[建议]**。

**第二阶段：浇注硅胶阴模**

1. 在阳模表面涂脱模剂（或凡士林薄层），防止硅胶粘连 **[建议]**。
2. 按照硅胶产品说明混合 A/B 组份，缓慢搅拌避免气泡 **[建议]**。
3. 将约 **130g** 硅胶缓慢浇注在阳模上，确保填满所有凹腔 **[原始]**。
4. 静置固化（一般 12-24 小时，取决于硅胶型号）**[建议]**。
5. 脱模，得到硅胶阴模——每个凹坑即为一颗棋子的形状。

**第三阶段：灌注树脂制作棋子**

1. **准备磁铁组件** **[原始]**：将 7×4mm N35 钕磁铁压入（或锤入）镀锌六角螺母 DIN 439 BM 8×1 中。
2. **⚠ 关键：磁极方向** **[原始]**
    * 黑子：磁铁 N 极朝上（传感器读数为负值，阈值 -40）
    * 白子：磁铁 S 极朝上（传感器读数为正值，阈值 +40）
    * 建议用记号笔在磁铁上标记方向，防止混淆 **[建议]**
3. **混合树脂** **[原始]**：按说明书比例混合环氧树脂 A/B 组份。黑子需额外加入 **5% 黑色色浆** **[原始]**。
4. **第一次灌注** **[原始]**：向硅胶模具每个凹坑注入 **0.3 ml** 树脂，形成棋子底层。
5. **放入磁铁** **[原始]**：待底层树脂稍微凝固（略有粘性但未完全固化）时 **[建议]**，将磁铁组件（螺母+磁铁）**按正确极性方向**放入凹坑中央。
6. **第二次灌注** **[原始]**：注入 **1.3 ml** 树脂，填满模具凹坑，将磁铁完全包裹。
7. **消除气泡** **[原始]**：用喷枪（或打火机快速掠过）加热树脂表面，气泡会自动破裂。
8. **固化**：室温静置至完全固化（通常 24 小时）**[建议]**。

**第四阶段：后处理**

1. 从硅胶模具中取出固化的棋子。
2. 打印 `stone_holder.f3d` 辅助夹具，在夹具孔中嵌入一颗磁铁——棋子会被磁力吸附固定，方便打磨 **[原始]**。
3. **湿磨** **[原始]**：用湿砂纸打磨棋子底面和边缘，去除毛刺和溢料。建议 400→800 目 **[建议]**。
4. **黑子特殊处理** **[原始]**：用异丙醇擦拭清洁，再涂少许抛光油增加光泽。
5. 成品每颗约 **3 克** **[原始]**，手感沉稳。

> **产量提示：** 19×19 棋盘需要至少 **361 颗棋子**（黑 181 + 白 180），建议每种多做 10-20 颗备用。按每副模具一次可做的数量估算批次。

#### 在家操作详细指导

> **原始资料与建议值说明：** 本节内容基于项目原始文件 `stones/README.md` 扩展而成。原始资料中明确指定的参数用 **[原始]** 标注，其余操作细节、参数推荐和采购建议均为编者补充（用 **[建议]** 标注），仅供参考，可根据实际情况调整。

如果你没有翻模经验，以下是更详细的逐步说明和常见问题解答。

**工具与耗材准备清单**

开始前确保手边有以下物品（大部分可在淘宝搜到）：

| 工具/耗材 | 用途 | 参考价格 |
| :--- | :--- | :--- |
| 电子秤（精度 0.1g） | 称量树脂和硅胶的 A/B 组份比例 | ~30 元 |
| 一次性塑料杯（50ml） | 混合树脂用，用完即弃 | ~10 元/50 个 |
| 一次性滴管（1-3ml） | 精确注入树脂到模具凹坑 | ~5 元/50 支 |
| 搅拌棒（木棒或塑料棒） | 搅拌树脂 | ~5 元 |
| 乳胶/丁腈手套 | 防止皮肤接触树脂（树脂有刺激性） | ~15 元/盒 |
| 口罩（活性炭或防有机气体） | 树脂固化时有气味 | ~20 元 |
| 旧报纸/硅胶垫 | 铺在桌面防粘 | 家中即有 |
| 热风枪或打火机 | 消除树脂表面气泡 | 热风枪 ~40 元 |
| 砂纸套装（400/800/1200 目） | 打磨阳模和成品棋子 | ~10 元 |
| 底漆喷罐 (Primer/Filler) | 填平阳模 3D 打印层纹 | ~25 元 |
| 记号笔 | 标记磁铁 N/S 极方向 | 家中即有 |

**第一阶段详解：3D 打印阳模**

> 如果没有 3D 打印机 **[建议]**，可以在淘宝搜"3D 打印代工"或使用嘉立创3D打印/未来工场等线上服务，上传 `.f3d` 导出的 STL 文件即可。材料选 PETG **[原始：G-code 文件中指定 Prusament PETG]**，层高 0.05mm **[原始]**。填充率 15-20% **[建议]**。

1. 打印完成后，阳模表面会有明显的打印层纹。这些纹路会 1:1 复制到硅胶模具再转移到棋子上，所以**必须打磨光滑**。
2. 打磨顺序：400 目干磨去大纹路 → 800 目湿磨（砂纸蘸水）→ 1200 目湿磨抛光。
3. 喷 1-2 层底漆（每层薄喷，间隔 10 分钟），底漆会填平微小凹坑。
4. 底漆干透后（约 30 分钟），用 800 目砂纸轻轻湿磨一遍。
5. 用手指触摸，感觉完全光滑无颗粒感即可进入下一步。

**第二阶段详解：浇注硅胶阴模**

> 硅胶推荐 **[建议]**：淘宝搜"翻模硅胶 食品级"或"模具硅胶 半透明"，选择邵氏硬度 20-30A、操作时间 30-60 分钟、混合比例 1:1 的型号。原始项目仅指定品牌 Wagnersil Premium（德国产品），国内平替可选普斯顿、宏图、红叶等。

1. **涂脱模剂**：在阳模表面薄薄涂一层凡士林（药店有售），用棉签抹匀。没有凡士林可用食用油代替，但凡士林效果更好。
2. **围挡**：用硬纸板或乐高积木在阳模四周围一圈"围墙"（高于阳模最高点约 5mm），底部用热熔胶封住防漏。
3. **混合硅胶**：
   - 用电子秤按产品说明的比例（通常 A:B = 1:1 或 10:1）称量。
   - 沿同一方向缓慢搅拌 3-5 分钟，避免快速搅打产生气泡。
   - **消泡技巧**：搅拌好的硅胶从高处（约 30cm）细线状缓慢倒入另一个杯子，气泡会在拉丝过程中破裂。重复 2 次效果更佳。如果有真空泵更好，但不是必须。
4. **浇注**：从一个角落缓慢倒入硅胶，让它自然流动填满所有凹腔，不要直接倒在阳模凸起部分上方。
5. **固化**：放在水平桌面上，室温 20-25°C 静置。不同硅胶固化时间不同（12-24 小时），不要提前脱模。
6. **脱模**：从边缘轻轻掀起硅胶，慢慢与阳模分离。硅胶有弹性，不易撕破。

**第三阶段详解：灌注树脂制作棋子**

> 树脂推荐 **[建议]**：淘宝搜"水晶滴胶 环氧树脂"或"AB 胶 透明环氧"。选择固化时间 24 小时的慢干型（不要选 5 分钟速干型，操作时间太短）。原始项目使用德国品牌双组份环氧树脂（Epoxidharz），国内同类产品均可。

1. **准备磁铁组件**：
   - 将磁铁塞入螺母中孔。7mm 磁铁配 M8 螺母，手按即可压入，如果较紧可用平头螺丝刀轻推。
   - **判断磁极**：拿一块已知极性的磁铁靠近——同极相斥、异极相吸。用记号笔在所有磁铁的 N 极面画一个点。
   - 将黑子用的磁铁组件和白子用的分开放置（例如分两个盒子），避免混淆。
2. **混合树脂**：
   - 白子：按 A:B 比例混合透明树脂。
   - 黑子：先将 5% 黑色色浆加入 A 组份中搅匀，再加入 B 组份混合。
   - 每次混合量：建议一次做 20-30 颗（约 32-48ml 树脂），时间充裕不慌张。
3. **第一次灌注（0.3ml/坑）**：用一次性滴管吸取树脂，逐坑注入。不需要非常精确，目的是形成一层薄底。
4. **等待 2-4 小时**：让底层树脂从液态变为"果冻态"（用牙签戳表面，有粘性但不流动）。这个时机放入磁铁最理想——磁铁不会沉底，也能与上层树脂良好结合。
5. **放入磁铁组件**：螺母朝下（平面朝下），磁铁朝上。注意极性方向。
6. **第二次灌注（1.3ml/坑）**：填满凹坑，树脂液面与模具齐平。
7. **消泡**：热风枪距离 10cm 快速扫过表面（停留不超过 2 秒/处），或用打火机火焰快速掠过。气泡遇热会上浮破裂。
8. **固化**：盖一张纸防灰尘落入，室温静置 24 小时。不要移动模具。
9. **处理残余树脂**：混合后的环氧树脂**不可倒入下水道**。将剩余树脂留在一次性杯子中，等待 24 小时自然固化成固体硬块后，作为普通固体垃圾丢弃即可（固化后化学性质稳定、无毒）。沾有树脂的搅拌棒、滴管、手套等耗材同样等固化后一起丢弃。注意不要将大量树脂（>50ml）集中在一个纸杯里，放热反应可能导致杯子过热变形。未混合的 A/B 组份可密封保存，保质期通常 6-12 个月。

**常见问题与解决**

| 问题 | 原因 | 解决方法 |
| :--- | :--- | :--- |
| 棋子表面有小气泡 | 树脂搅拌时带入空气 | 搅拌后静置 5 分钟再灌注；灌注后用热风枪消泡 |
| 棋子发黄/发雾 | 树脂受潮或 A/B 比例不准 | 严格按比例称量；树脂存放在干燥处 |
| 磁铁沉底偏位 | 第一次灌注后等待时间不够 | 等底层树脂变为果冻态再放磁铁 |
| 棋子粘在模具里取不出 | 硅胶模具表面不够光滑 | 灌注前在模具凹坑喷薄层脱模剂 |
| 黑子颜色不均匀 | 色浆没有充分搅匀 | 先将色浆与 A 组份单独搅拌 3 分钟 |
| 棋子厚薄不一致 | 灌注量不均匀 | 使用带刻度的滴管；灌注后检查液面齐平 |

#### 工厂代工方案 [建议]

> 以下代工方案、搜索关键词和费用估算均为编者补充，仅供参考。

如果觉得在家操作不方便（没有 3D 打印机、不想处理树脂气味等），可以将各阶段外包：

**方案 A：全部外包（最省事）**

联系一家"小批量硅胶/树脂制品厂"，提供以下资料即可：
- 棋子 3D 模型文件（从 `go_stones_mold.f3d` 导出 STEP 或 STL）
- 材质要求：透明环氧树脂（白子）/ 黑色环氧树脂（黑子）
- 嵌件要求：每颗内嵌 7×4mm N35 磁铁 + DIN 439 M8×1 镀锌螺母，提供磁极方向示意图
- 数量：黑 200 + 白 200 颗

搜索关键词（1688/淘宝）：
- "小批量树脂代工" / "环氧树脂浇铸加工"
- "硅胶模具代工" / "滴胶代工"
- 地区推荐：义乌、深圳、东莞（树脂工艺品产业集中）

预估费用：模具费 200-500 元 + 单颗棋子 1-3 元（含材料和人工），总计约 **1000-2000 元 / 400 颗**。

**方案 B：自己做模具，代工灌注（折中）**

1. 3D 打印阳模：线上打印服务（嘉立创3D打印/未来工场），约 50-100 元
2. 自己浇硅胶模具（一次性工作，难度不大）
3. 将硅胶模具 + 磁铁组件 + 树脂寄给代工厂，让他们批量灌注

这样你可以控制模具质量，同时省去最繁琐的 361 次重复灌注工作。

**方案 C：全部自己做（最省钱）**

材料成本估算：

| 材料 | 费用 |
| :--- | :--- |
| 环氧树脂（约 600ml） | ~50 元 |
| 黑色色浆 | ~15 元 |
| 翻模硅胶（130g） | ~30 元 |
| 磁铁 400 颗 | ~30 元 |
| 螺母 400 颗 | ~50 元 |
| 底漆 + 砂纸 + 耗材 | ~50 元 |
| **合计** | **~225 元** |

> **建议：** 如果是第一次做，先用方案 C 做 10-20 颗练手，熟悉流程后再决定是批量自己做还是找代工。

---

## 2. 核心软件工具链

| 软件 | 作用 | 备注 |
| :--- | :--- | :--- |
| **Autodesk Fusion 360** | **3D 建模 (CAD)**：查看、修改棋盘、支架、模具的所有 3D 模型。 | 工业标准，建议必装。 |
| **KiCad** | **电路设计 (EDA)**：打开 `.kicad_pcb` 文件，查看或修改电路板。 | 开源免费。 |
| **PrusaSlicer / Bambu Studio** | **3D 打印切片**：将 3D 模型转化为打印机识别的 `.gcode`。 | 准备打印实物的最后一步。 |
| **Inkscape / AutoCAD** | **矢量图处理**：查看或修改 `.dxf` 切割图。 | 处理 2D 零件（如棋盘面）。 |

---

## 3. 分步指导计划

### 第一步：查看模型 (2.1)

#### 详细文件清单 (Module File List)

以下是各模块的核心设计文件及其查看/编辑所需的软件：

**A. 棋盘结构 (Board Structure)**
主要涉及木工 CNC 加工和激光切割文件。

| 文件路径 | 文件名 | 说明 | 推荐软件 |
| :--- | :--- | :--- | :--- |
| `board/cnc_files/` | `Top.f3d` | 棋盘顶层面板的 3D 源文件，包含开孔和槽位设计。 | **Fusion 360** |
| | `top.dxf` | 用于激光切割或 CNC 的 2D 矢量图（顶层）。 | **AutoCAD** / **Inkscape** |
| | `grid.f3d` | 棋盘网格层的 3D 源文件（用于透光显示网格）。 | **Fusion 360** |
| | `grid.dxf` | 网格层的 2D 切割图。 | **AutoCAD** / **Inkscape** |
| | `bottom.f3d` | 棋盘底层背板的 3D 源文件。 | **Fusion 360** |
| | `bottom.dxf` | 底层背板的 2D 切割图。 | **AutoCAD** / **Inkscape** |
| | `side.f3d` / `side.dxf` | 棋盘侧边框的 3D 模型与 2D 切割图。 | **Fusion 360** / **AutoCAD** |
| `board/3d_prints/` | `pen_part1.f3d`, `pen_part2.f3d` | 辅助工具或装饰件的 3D 模型。 | **Fusion 360** |

**B. 电子系统 (Electronics)**
涉及 PCB 电路设计和电子元件的 3D 打印支架。

| 文件路径 | 文件名 | 说明 | 推荐软件 |
| :--- | :--- | :--- | :--- |
| `electronics/kicad_files/8x8/` | `8x8.kicad_pro` | 8x8 传感器阵列主板的项目文件。 | **KiCad** |
| | `8x8.kicad_pcb` | 8x8 主板的 PCB 布局文件。 | **KiCad** (PCB Editor) |
| | `8x8.kicad_sch` | 8x8 主板的电路原理图。 | **KiCad** (Schematic Editor) |
| `electronics/kicad_files/[11x3, 3x8, 8x3]/` | `*.kicad_pcb` | 边缘补丁板的 PCB 文件，用于拼接完整棋盘。 | **KiCad** |
| `electronics/3d_prints/` | `*_pcb_mask.f3d` | PCB 遮光罩与固定件的 3D 模型（如 `8x8_pcb_mask.f3d`）。 | **Fusion 360** |
| | `raspberry_pi_mount.f3d` | 树莓派固定支架的 3D 模型。 | **Fusion 360** |
| | `*.gcode` | 预先切片好的打印文件（针对特定打印机）。 | 直接导入 3D 打印机 (如 Prusa) |

**C. 棋子与模具 (Stones & Molds)**
涉及棋子翻模制作所需的 3D 打印模具。

| 文件路径 | 文件名 | 说明 | 推荐软件 |
| :--- | :--- | :--- | :--- |
| `stones/3d_prints/` | `go_stones_mold.f3d` | 棋子模具的 3D 源文件。 | **Fusion 360** |
| | `stone_holder.f3d` | 棋子收纳架或固定器的 3D 模型。 | **Fusion 360** |
| | `*.gcode` | 模具与收纳架的打印切片文件。 | 直接导入 3D 打印机 |

#### 操作演示
1.  **3D 模型**: 打开 Fusion 360，使用 `File -> Open` 打开 `board/cnc_files/top.f3d`。
    *   *操作技巧*: 按住鼠标中键平移，`Shift + 鼠标中键` 旋转，滚轮缩放。
2.  **电路板**: 打开 KiCad，进入 `PCB Editor` 载入 `electronics/kicad_files/8x8/8x8.kicad_pcb`。
    *   *操作技巧*: 按 `Alt + 3` 可以在 KiCad 中直接查看 PCB 的 3D 效果图。

### 第二步：修改模型 (2.2)
1.  **参数化修改 (Fusion 360)**: 找到底部的 **时间轴 (Timeline)**。如果你想改某个孔的大小，右键点击对应的“草图 (Sketch)”，选择 `Edit Sketch`。
2.  **联动修改**: 如果你改变了 PCB 的尺寸，你必须同步在 Fusion 360 中导入 PCB 的 3D 模型（在 KiCad 中导出为 `.step`），以确保外壳孔位依然匹配。

### 第三步：联系厂商生产 (2.3)
当你准备好文件后，如何跟加工厂沟通？

#### A. PCB 生产与 SMT 贴片 (找嘉立创等厂商)
*   **推荐导出流程 (KiCad 一键导出)**:
    1.  **安装插件**: 在 KiCad 主界面的 `Plugin and Content Manager` 中安装 **Fabrication Toolkit**。
    2.  **一键生成**: 打开 `.kicad_pcb` 文件，点击工具栏插件图标 -> `Generate`。
    3.  **获取文件**: 插件会在项目下生成 `production/` 文件夹，包含：
        *   `*.zip`: **Gerber 文件**（裸板生产用）。
        *   `bom.csv`: **物料清单**（SMT 贴片用）。
        *   `positions.csv`: **坐标文件**（SMT 贴片用，即 CPL/POS）。
*   **核心生产参数**: 
    *   **层数 (Layers)**: 2层。
    *   **板厚 (Thickness)**: 1.6mm。
    *   **阻焊颜色 (Solder Mask)**: 强烈建议选**白色**（漫反射 LED 灯光，视觉效果更均匀）。
    *   **表面工艺**: 有铅/无铅喷锡或沉金均可。

#### B. 3D 打印 (找网上的打印服务)
*   **术语**: “我要打印这个零件，格式是 **STL** 或 **STEP**，材料用 **PETG** 或 **PLA**。”
*   **核心参数**: 
    *   **填充率 (Infill)**: 15%-20% 即可，受力件建议 40% 以上。
    *   **层高 (Layer Height)**: 0.2mm 是常规精度，0.1mm 是高精度。

#### C. CNC / 激光切割 (处理木材或亚克力)
*   **术语**: "请按照这个 **DXF** 文件进行**激光切割**（或 **CNC 铣削**），材料用 **5mm 厚的胡桃木板**（或亚克力）。"
*   **核心参数**:
    *   **切割 vs 雕刻**: 告诉师傅哪些线条是"切断"，哪些是"浅层雕刻"（如棋盘的网格线）。
    *   **比例单位**: 务必强调"单位是 **毫米 (mm)**"，防止厂商导入时比例缩放错误。

---

## 4. 整机组装指南 (Full Assembly Guide)

所有零件生产完成后，按以下顺序组装。

### 4.1 棋盘层叠结构 (Board Layer Stack-up)

棋盘由 4 层木板从下到上叠合而成，所有木板均通过 CNC 或激光切割（文件位于 `board/cnc_files/`）：

```
  ┌─────────────────────────────────┐
  │  ④ 顶层 Top (6.5mm 胶合板)     │  ← 棋盘表面，361 个 LED 透光孔，覆 0.6mm 木皮
  ├─────────────────────────────────┤
  │  ③ 网格层 Grid (6.5mm 胶合板)  │  ← LED 对准孔，透光显示网格线
  ├─────────────────────────────────┤
  │  ② 侧框 Side (10mm 胶合板)     │  ← 四周围框，形成内部空腔容纳电子元件
  ├─────────────────────────────────┤
  │  ① 底板 Bottom (5mm 胶合板)    │  ← 结构底板
  └─────────────────────────────────┘
```

### 4.2 组装步骤

#### 步骤一：木框粘合

1.  将**底板** (`bottom.dxf`)、**侧框** (`side.dxf`)、**网格层** (`grid.dxf`) 三层用木工胶粘合。
2.  夹紧，静置一夜等胶水完全固化。
3.  打磨接合面，确保平整。

#### 步骤二：3D 打印辅助件

打印以下零件（建议使用 PETG 材料）：

| 文件 | 用途 |
| :--- | :--- |
| `electronics/3d_prints/8x8_pcb_mask.f3d` | 8×8 PCB 遮光罩/固定件（×4） |
| `electronics/3d_prints/3x8_pcb_mask.f3d` | 3×8 PCB 遮光罩/固定件（×2） |
| `electronics/3d_prints/11x3_pcb_mask.f3d` | 11×3 PCB 遮光罩/固定件（×1） |
| `electronics/3d_prints/8x3_pcb_mask.f3d` | 8×3 PCB 遮光罩/固定件（×1） |
| `electronics/3d_prints/raspberry_pi_mount.f3d` | 树莓派固定支架（×1） |

PCB 遮光罩有双重作用：SMT 回流焊时保护另一面；组装时为 PCB 提供定位和支撑。

#### 步骤三：安装电子元件

按照 1.2 节的拼接布局图，将 8 块 PCB 子板装入木框空腔：

1.  **放置 PCB 遮光罩**到网格层下方对应位置。
2.  **安装 PCB 子板**，使用不锈钢螺丝固定（**必须用无磁性不锈钢**，避免干扰霍尔传感器）。
3.  **互联子板**：相邻子板通过边缘的排针/排母连接器（2.54mm 间距）对插：
    *   **Hall_top / Hall_bottom**：霍尔传感器信号，纵向相邻板之间。
    *   **PQ_side_a / PQ_side_b**：多路复用器控制信号，横向相邻板之间。
    *   **LedIn / LedOut**：LED 数据链路（Data, 5V, GND），在板间级联。
    *   **Touch_side_a / Touch_side_b**：触摸信号。
    *   **Power**：5V 电源分配。
4.  **安装 ESP32-S3**：插入其中一块 8×8 主板上的插座。
5.  **安装树莓派**：使用 3D 打印支架 (`raspberry_pi_mount.f3d`) 固定在空腔内（螺丝孔 3mm）。

#### 步骤四：供电接线

*   使用 **5V/10A (50W) 外部电源**。
*   通过端子台转接头接入侧板开孔，为 PCB 阵列和树莓派统一供电。
*   电源通过子板间的 Power 连接器在所有 8 块 PCB 之间分配。

#### 步骤五：安装顶层面板

1.  在顶层木板 (`top.dxf`) 表面贴合 **0.6mm 木皮**，用胶水粘合后熨烫压实。
2.  从内侧向 LED 孔中**灌入透明树脂**，保护 LED 并增强结构强度。
3.  涂刷 **4 层聚氨酯漆**（每层之间轻打磨）。
4.  使用 CNC 笔式绘图仪在表面**绘制棋盘网格线**。
5.  最终再涂一层聚氨酯漆保护网格线。
6.  将顶层面板固定到木框上。

#### 步骤六：制作棋子

1.  使用 `stones/3d_prints/go_stones_mold.f3d` 3D 打印硅胶模具。
2.  准备 7×4mm N35 钕磁铁，压入镀锌六角螺母（DIN 439 BM 8×1）中。
3.  将磁铁+螺母放入模具，灌入树脂，固化后脱模（每颗约 3g）。
4.  **关键：黑子和白子使用相反的磁极方向**，霍尔传感器通过正/负磁场区分棋子颜色。

### 4.3 功能验证

组装完成后，进行以下检查：

1.  **上电测试**：接通 5V 电源，确认 ESP32 和树莓派正常启动。
2.  **WiFi 连接**：连接到 ESP32 创建的 `saiboard` WiFi 网络。
3.  **传感器校准**：ESP32 启动时会进行 20 轮校准读数（`nr_of_boot_up_rounds = 20`），此时棋盘上不要放棋子。
4.  **LED 测试**：通过后端服务发送 LED 指令，确认 361 颗 LED 全部正常点亮。
5.  **棋子检测**：分别放置黑子和白子，确认传感器能正确区分（白子阈值 40，黑子阈值 -40）。
6.  **Web 界面**：浏览器访问 `192.168.4.5:8000`，确认 Flutter 界面正常加载并显示棋盘状态。
