shevapato2008/saiboard/conductor/tracks/setup_bridge_20260116/index.md

# Track setup_bridge_20260116 Context

- [Specification](./spec.md)
- [Implementation Plan](./plan.md)
- [Metadata](./metadata.json)
