shevapato2008/saiboard/electronics/kicad_files/11x3/11x3.kicad_pcb

## KiCad design electronics/kicad_files/11x3/11x3.kicad_pcb (2026-03-14)

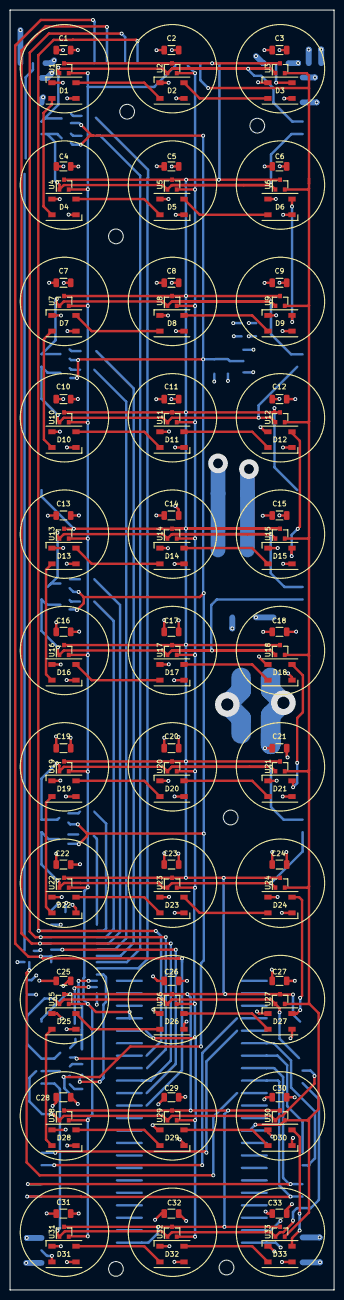
[picture p1: board 11x3.kicad_pcb from above]

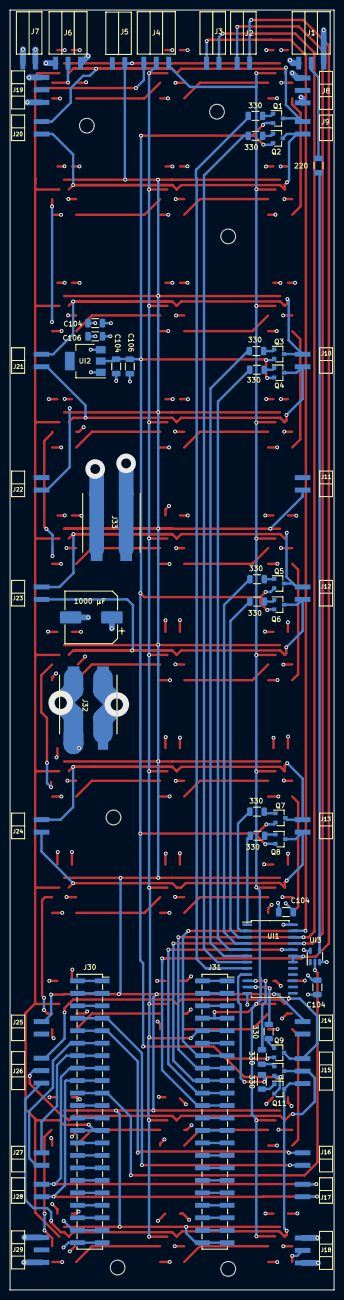
[picture p2: board 11x3.kicad_pcb from below]

Board: 4 copper layers, 66.0 x 260.7 mm, 171 parts (66 on the bottom side), 114 nets.

Parts:
C1, C2, C3, C4, C5, C6, C7, C8, C9, C10, C11, C12, C13, C14, C15, C16, C17, C18, C19, C20, C21, C22, C23, C24, C25, C26, C27, C28, C29, C30, C31, C32, C33: C104; C_1206_3216Metric
CI1, CI3, CI4, CI6: C104; C_1206_3216Metric
CI2, CI5: C106; C_1206_3216Metric
CP1: 1000 µF; CP_Elec_10x10.5
D1, D2, D3, D4, D5, D6, D7, D8, D9, D10, D11, D12, D13, D14, D15, D16, D17, D18, D19, D20, D21, D22, D23, D24, D25, D26, D27, D28, D29, D30, D31, D32, D33: SK6812; LED_SK6812_PLCC4_5.0x5.0mm_P3.2mm
J1: Power_top_side_a; PinSocket_1x03_P2.54mm_Horizontal_SMD
J2: IC_top_1; PinSocket_1x02_P2.54mm_Horizontal_SMD
J3: IC_top_2; PinSocket_1x02_P2.54mm_Horizontal_SMD
J4: Hall_top; PinSocket_1x03_P2.54mm_Horizontal_SMD
J5: Touch_top; PinSocket_1x02_P2.54mm_Horizontal_SMD
J6: Power_top; PinSocket_1x03_P2.54mm_Horizontal_SMD
J7: Power_top_side_b; PinSocket_1x02_P2.54mm_Horizontal_SMD
J8: Power_side_a; PinHeader_1x03_P2.54mm_Horizontal_SMD
J9, J10, J12, J13: PQ_side_a; PinHeader_1x02_P2.54mm_Horizontal_SMD
J11: Touch_side_a; PinHeader_1x02_P2.54mm_Horizontal_SMD
J14: Touch_bottom_side_a; PinHeader_1x02_P2.54mm_Horizontal_SMD
J15: PQ_bottom_side_a; PinHeader_1x03_P2.54mm_Horizontal_SMD
J16: Hall_bottom_side_a; PinHeader_1x02_P2.54mm_Horizontal_SMD
J17: IC_bottom_side_a; PinHeader_1x02_P2.54mm_Horizontal_SMD
J18: Power_bottom_side_a; PinHeader_1x03_P2.54mm_Horizontal_SMD
J19: Power_side_b; PinHeader_1x03_P2.54mm_Horizontal_SMD
J20, J21, J23, J24: PQ_side_b; PinHeader_1x02_P2.54mm_Horizontal_SMD
J22: Touch_side_b; PinHeader_1x02_P2.54mm_Horizontal_SMD
J25: Touch_bottom_side_b; PinHeader_1x02_P2.54mm_Horizontal_SMD
J26: PQ_bottom_side_b; PinHeader_1x03_P2.54mm_Horizontal_SMD
J27: Hall_bottom_side_b; PinHeader_1x02_P2.54mm_Horizontal_SMD
J28: IC_bottom_side_b; PinHeader_1x02_P2.54mm_Horizontal_SMD
J29: Power_bottom_side_b; PinHeader_1x03_P2.54mm_Horizontal_SMD
J30: esp32s3left; PinSocket_2x22_P2.54mm_Vertical_SMD
J31: esp32s3right; PinSocket_2x22_P2.54mm_Vertical_SMD
J32: Power_Terminal; Wago_2601-602
J33: Power_RaspberryPi; Wago_2601-602
M1, M2, M5, M6, M6#2, M6#3: MountingHole_3mm
Q1, Q2, Q3, Q4, Q5, Q6, Q7, Q8, Q9, Q10, Q11: 2N3906; SOT-23
R1, R2, R3, R4, R5, R6, R7, R8, R9, R10, R11: 330; R_1206_3216Metric
RI1: 220; R_1206_3216Metric
U1, U2, U3, U4, U5, U6, U7, U8, U9, U10, U11, U12, U13, U14, U15, U16, U17, U18, U19, U20, U21, U22, U23, U24, U25, U26, U27, U28, U29, U30, U31, U32, U33: AH49E; SOT-23
UI1: 74HCT154D; SOP-24_7.5x15.4mm_P1.27mm
UI2: AMS1117-3.3; SOT-223
UI3: SN74LV1T34; SOT-23-5

Connections:
A0: J3.2, J31.13, J31.14, UI1.23 (A0)
A1: J3.1, J31.15, J31.16, UI1.22 (A1)
A2: J2.2, J31.17, J31.18, UI1.21 (A2)
A3: J31.19, J31.20, UI1.20 (A3)
AGND: J5.1, J11.1, J14.2, J22.2, J25.1, J31.43, J31.44, U1.3 (GND), U2.3 (GND), U3.3 (GND), U4.3 (GND), U5.3 (GND), U6.3 (GND), U7.3 (GND), U8.3 (GND), U9.3 (GND), U10.3 (GND), U11.3 (GND), U12.3 (GND), U13.3 (GND), U14.3 (GND), U15.3 (GND), U16.3 (GND), U17.3 (GND), U18.3 (GND), U19.3 (GND), U20.3 (GND), U21.3 (GND), U22.3 (GND), U23.3 (GND), U24.3 (GND), U25.3 (GND), U26.3 (GND), U27.3 (GND), U28.3 (GND), U29.3 (GND), U30.3 (GND), U31.3 (GND), U32.3 (GND), U33.3 (GND)
Additional1: J30.1, J30.2
Additional2: J30.3, J30.4
Additional3: J30.5, J30.6
Additional4: J30.21, J30.22
Additional5: J30.23, J30.24
Additional6: J30.27, J30.28
Additional7: J30.29, J30.30
Additional8: J30.31, J30.32
Additional9: J30.33, J30.34
Additional10: J30.35, J30.36
Additional11: J30.37, J30.38
Additional12: J30.39, J30.40
Additional13: J31.1, J31.2
Additional14: J31.3, J31.4
Additional15: J31.5, J31.6
Additional16: J31.11, J31.12
Additional17: J31.23, J31.24
Additional18: J31.25, J31.26
Additional19: J31.27, J31.28
Additional20: J31.29, J31.30
Additional21: J31.31, J31.32
Additional22: J31.33, J31.34
Additional23: J31.35, J31.36
Additional24: J31.37, J31.38
Additional25: J31.39, J31.40
Additional26: J31.41, J31.42
E: J2.1, J31.21, J31.22, UI1.18 (E0), UI1.19 (E1)
First_LedIn_3V: J30.19, J30.20, UI3.2 (A)
GND: C1.2, C2.2, C3.2, C4.2, C5.2, C6.2, C7.2, C8.2, C9.2, C10.2, C11.2, C12.2, C13.2, C14.2, C15.2, C16.2, C17.2, C18.2, C19.2, C20.2, C21.2, C22.2, C23.2, C24.2, C25.2, C26.2, C27.2, C28.2, C29.2, C30.2, C31.2, C32.2, C33.2, CI1.1, CI2.1, CI3.1, CI4.1, CI5.1, CI6.2, CP1.2, D1.1 (VSS), D2.1 (VSS), D3.1 (VSS), D4.1 (VSS), D5.1 (VSS), D6.1 (VSS), D7.1 (VSS), D8.1 (VSS), D9.1 (VSS), D10.1 (VSS), D11.1 (VSS), D12.1 (VSS), D13.1 (VSS), D14.1 (VSS), D15.1 (VSS), D16.1 (VSS), D17.1 (VSS), D18.1 (VSS), D19.1 (VSS), D20.1 (VSS), D21.1 (VSS), D22.1 (VSS), D23.1 (VSS), D24.1 (VSS), D25.1 (VSS), D26.1 (VSS), D27.1 (VSS), D28.1 (VSS), D29.1 (VSS), D30.1 (VSS), D31.1 (VSS), D32.1 (VSS), D33.1 (VSS), J1.1, J6.3, J7.2, J8.3, J18.3, J19.1, J29.1, J30.43, J30.44, J32.2, J33.2, UI1.12 (GND), UI2.1 (GND), UI3.3 (GND)
HallOut1: J4.1, J31.7, J31.8, U1.2 (OUT), U4.2 (OUT), U7.2 (OUT), U10.2 (OUT), U13.2 (OUT), U16.2 (OUT), U19.2 (OUT), U22.2 (OUT), U25.2 (OUT), U28.2 (OUT), U31.2 (OUT)
HallOut2: J4.2, J31.9, J31.10, U2.2 (OUT), U5.2 (OUT), U8.2 (OUT), U11.2 (OUT), U14.2 (OUT), U17.2 (OUT), U20.2 (OUT), U23.2 (OUT), U26.2 (OUT), U29.2 (OUT), U32.2 (OUT)
HallOut3: J4.3, J30.25, J30.26, U3.2 (OUT), U6.2 (OUT), U9.2 (OUT), U12.2 (OUT), U15.2 (OUT), U18.2 (OUT), U21.2 (OUT), U24.2 (OUT), U27.2 (OUT), U30.2 (OUT), U33.2 (OUT)
HallOut4: J16.1, J30.7, J30.8
HallOut5: J16.2, J30.9, J30.10
HallOut6: J27.2, J30.11, J30.12
HallOut7: J27.1, J30.13, J30.14
LedIn: D31.2 (DIN), J18.2
LedIn_top_side_a: J1.2, RI1.2
LedOut: D3.4 (DOUT), J6.2
unnamed: D1.2 (DIN), D4.4 (DOUT)
unnamed: D1.4 (DOUT), D2.2 (DIN)
unnamed: D2.4 (DOUT), D3.2 (DIN)
unnamed: D4.2 (DIN), D5.4 (DOUT)
unnamed: D5.2 (DIN), D6.4 (DOUT)
unnamed: D6.2 (DIN), D9.4 (DOUT)
unnamed: D7.4 (DOUT), D8.2 (DIN)
unnamed: D8.4 (DOUT), D9.2 (DIN)
unnamed: D10.2 (DIN), D11.4 (DOUT)
unnamed: D7.2 (DIN), D10.4 (DOUT)
unnamed: D11.2 (DIN), D12.4 (DOUT)
unnamed: D12.2 (DIN), D15.4 (DOUT)
unnamed: D13.2 (DIN), D16.4 (DOUT)
unnamed: D13.4 (DOUT), D14.2 (DIN)
unnamed: D14.4 (DOUT), D15.2 (DIN)
unnamed: D16.2 (DIN), D17.4 (DOUT)
unnamed: D17.2 (DIN), D18.4 (DOUT)
unnamed: D18.2 (DIN), D21.4 (DOUT)
unnamed: D19.2 (DIN), D22.4 (DOUT)
unnamed: D19.4 (DOUT), D20.2 (DIN)
unnamed: D20.4 (DOUT), D21.2 (DIN)
unnamed: D22.2 (DIN), D23.4 (DOUT)
unnamed: D23.2 (DIN), D24.4 (DOUT)
unnamed: D24.2 (DIN), D27.4 (DOUT)
unnamed: D25.2 (DIN), D28.4 (DOUT)
unnamed: D25.4 (DOUT), D26.2 (DIN)
unnamed: D26.4 (DOUT), D27.2 (DIN)
unnamed: D28.2 (DIN), D29.4 (DOUT)
unnamed: D29.2 (DIN), D30.4 (DOUT)
unnamed: D30.2 (DIN), D33.4 (DOUT)
unnamed: D31.4 (DOUT), D32.2 (DIN)
unnamed: D32.4 (DOUT), D33.2 (DIN)
unnamed: Q1.1 (B), R1.2
unnamed: Q2.1 (B), R2.2
unnamed: Q3.1 (B), R3.2
unnamed: Q4.1 (B), R4.2
unnamed: Q5.1 (B), R5.2
unnamed: Q6.1 (B), R6.2
unnamed: Q7.1 (B), R7.2
unnamed: Q8.1 (B), R8.2
unnamed: Q9.1 (B), R9.2
unnamed: Q10.1 (B), R10.2
unnamed: Q11.1 (B), R11.2
unnamed: RI1.1, UI3.4 (Y)
P: C1.1, C2.1, C3.1, C4.1, C5.1, C6.1, C7.1, C8.1, C9.1, C10.1, C11.1, C12.1, C13.1, C14.1, C15.1, C16.1, C17.1, C18.1, C19.1, C20.1, C21.1, C22.1, C23.1, C24.1, C25.1, C26.1, C27.1, C28.1, C29.1, C30.1, C31.1, C32.1, C33.1, CI1.2, CI2.2, CI3.2, CI6.1, CP1.1, D1.3 (VDD), D2.3 (VDD), D3.3 (VDD), D4.3 (VDD), D5.3 (VDD), D6.3 (VDD), D7.3 (VDD), D8.3 (VDD), D9.3 (VDD), D10.3 (VDD), D11.3 (VDD), D12.3 (VDD), D13.3 (VDD), D14.3 (VDD), D15.3 (VDD), D16.3 (VDD), D17.3 (VDD), D18.3 (VDD), D19.3 (VDD), D20.3 (VDD), D21.3 (VDD), D22.3 (VDD), D23.3 (VDD), D24.3 (VDD), D25.3 (VDD), D26.3 (VDD), D27.3 (VDD), D28.3 (VDD), D29.3 (VDD), D30.3 (VDD), D31.3 (VDD), D32.3 (VDD), D33.3 (VDD), J1.3, J6.1, J7.1, J8.1, J18.1, J19.3, J29.3, J30.41, J30.42, J32.1, J33.1, UI1.24 (VCC), UI2.3 (VI), UI3.5 (VCC)
P3.3: CI4.2, CI5.2, Q1.2 (E), Q2.2 (E), Q3.2 (E), Q4.2 (E), Q5.2 (E), Q6.2 (E), Q7.2 (E), Q8.2 (E), Q9.2 (E), Q10.2 (E), Q11.2 (E), UI2.2 (VO)
PQ1: J9.2, J20.1, Q1.3 (C), U1.1 (VCC), U2.1 (VCC), U3.1 (VCC)
PQ2: J9.1, J20.2, Q2.3 (C), U4.1 (VCC), U5.1 (VCC), U6.1 (VCC)
PQ3: J10.2, J21.1, Q3.3 (C), U7.1 (VCC), U8.1 (VCC), U9.1 (VCC)
PQ4: J10.1, J21.2, Q4.3 (C), U10.1 (VCC), U11.1 (VCC), U12.1 (VCC)
PQ5: J12.2, J23.1, Q5.3 (C), U13.1 (VCC), U14.1 (VCC), U15.1 (VCC)
PQ6: J12.1, J23.2, Q6.3 (C), U16.1 (VCC), U17.1 (VCC), U18.1 (VCC)
PQ7: J13.2, J24.1, Q7.3 (C), U19.1 (VCC), U20.1 (VCC), U21.1 (VCC)
PQ8: J13.1, J24.2, Q8.3 (C), U22.1 (VCC), U23.1 (VCC), U24.1 (VCC)
PQ9: J15.3, J26.1, Q9.3 (C), U25.1 (VCC), U26.1 (VCC), U27.1 (VCC)
PQ10: J15.2, J26.2, Q10.3 (C), U28.1 (VCC), U29.1 (VCC), U30.1 (VCC)
PQ11: J15.1, J26.3, Q11.3 (C), U31.1 (VCC), U32.1 (VCC), U33.1 (VCC)
Q1: R1.1, UI1.8 (Y7)
Q2: R2.1, UI1.7 (Y6)
Q3: R3.1, UI1.6 (Y5)
Q4: R4.1, UI1.5 (Y4)
Q5: R5.1, UI1.4 (Y3)
Q6: R6.1, UI1.3 (Y2)
Q7: R7.1, UI1.2 (Y1)
Q8: R8.1, UI1.1 (Y0)
Q9: R9.1, UI1.11 (Y10)
Q10: R10.1, UI1.10 (Y9)
Q11: R11.1, UI1.9 (Y8)
S0: J17.2, J28.1, J30.15, J30.16
S1: J17.1, J28.2, J30.17, J30.18
