shevapato2008/saiboard/electronics/kicad_files/3x8/3x8.kicad_pcb

## KiCad design electronics/kicad_files/3x8/3x8.kicad_pcb (2026-02-02)

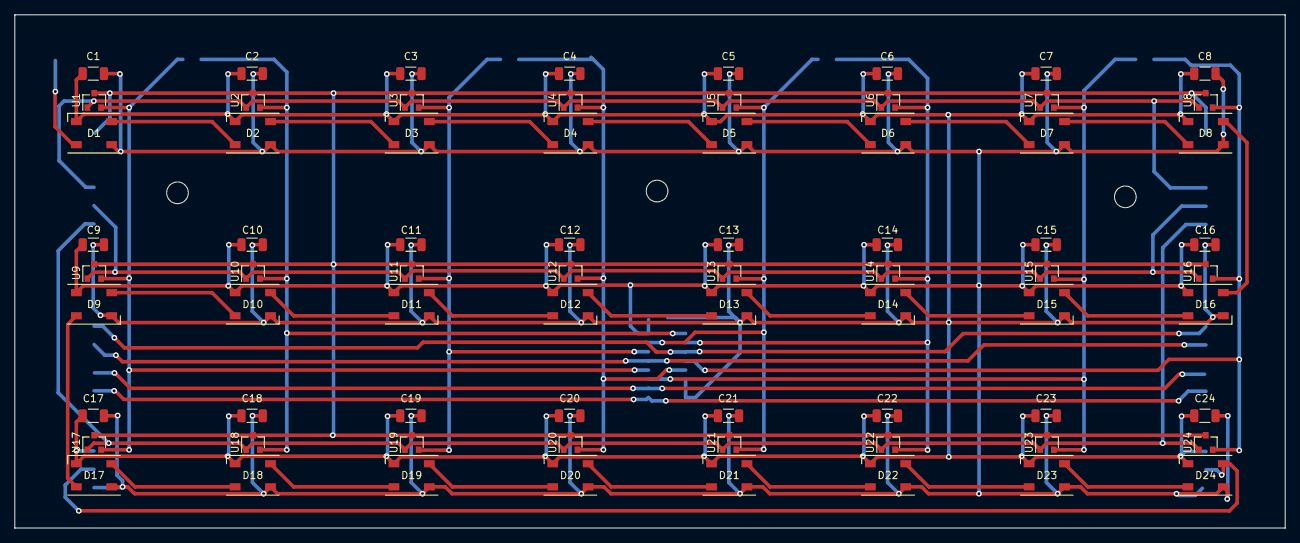
[picture p3: board 3x8.kicad_pcb from above]

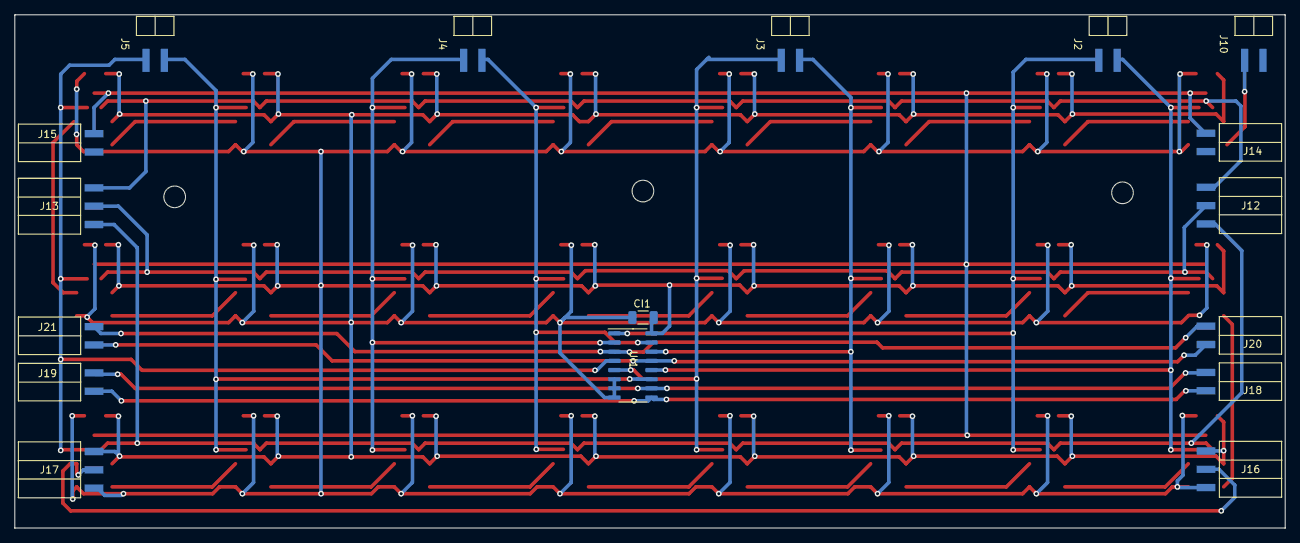
[picture p4: board 3x8.kicad_pcb from below]

Board: 2 copper layers, 176.0 x 71.1 mm, 92 parts (17 on the bottom side), 43 nets.

Parts:
C1, C2, C3, C4, C5, C6, C7, C8, C9, C10, C11, C12, C13, C14, C15, C16, C17, C18, C19, C20, C21, C22, C23, C24: C104; C_1206_3216Metric
CI1: C104; C_1206_3216Metric
D1, D2, D3, D4, D5, D6, D7, D8, D9, D10, D11, D12, D13, D14, D15, D16, D17, D18, D19, D20, D21, D22, D23, D24: SK6812; LED_SK6812_PLCC4_5.0x5.0mm_P3.2mm
J2, J3, J4, J5: Hall_top; PinHeader_1x02_P2.54mm_Horizontal_SMD
J10: LedIn; PinHeader_1x02_P2.54mm_Horizontal_SMD
J12: PQ_side_a; PinSocket_1x03_P2.54mm_Horizontal_SMD
J13: PQ_side_b; PinSocket_1x03_P2.54mm_Horizontal_SMD
J14: Touch_side_a; PinSocket_1x02_P2.54mm_Horizontal_SMD
J15: Touch_side_b; PinSocket_1x02_P2.54mm_Horizontal_SMD
J16: LedOut_side_a; PinSocket_1x03_P2.54mm_Horizontal_SMD
J17: LedOut_side_b; PinSocket_1x03_P2.54mm_Horizontal_SMD
J18: IC_side_a; PinSocket_1x02_P2.54mm_Horizontal_SMD
J19: IC_side_b; PinSocket_1x02_P2.54mm_Horizontal_SMD
J20: Hall_side_a; PinSocket_1x02_P2.54mm_Horizontal_SMD
J21: Hall_side_b; PinSocket_1x02_P2.54mm_Horizontal_SMD
M1, M2, M3: MountingHole_3mm
U1, U2, U3, U4, U5, U6, U7, U8, U9, U10, U11, U12, U13, U14, U15, U16, U17, U18, U19, U20, U21, U22, U23, U24: AH49E; SOT-23
UI1: 74hc4052D; SO-16_3.9x9.9mm_P1.27mm

Connections:
AGND: J14.2, J15.1, U1.3 (GND), U2.3 (GND), U3.3 (GND), U4.3 (GND), U5.3 (GND), U6.3 (GND), U7.3 (GND), U8.3 (GND), U9.3 (GND), U10.3 (GND), U11.3 (GND), U12.3 (GND), U13.3 (GND), U14.3 (GND), U15.3 (GND), U16.3 (GND), U17.3 (GND), U18.3 (GND), U19.3 (GND), U20.3 (GND), U21.3 (GND), U22.3 (GND), U23.3 (GND), U24.3 (GND)
GND: C1.2, C2.2, C3.2, C4.2, C5.2, C6.2, C7.2, C8.2, C9.2, C10.2, C11.2, C12.2, C13.2, C14.2, C15.2, C16.2, C17.2, C18.2, C19.2, C20.2, C21.2, C22.2, C23.2, C24.2, CI1.2, D1.1 (VSS), D2.1 (VSS), D3.1 (VSS), D4.1 (VSS), D5.1 (VSS), D6.1 (VSS), D7.1 (VSS), D8.1 (VSS), D9.1 (VSS), D10.1 (VSS), D11.1 (VSS), D12.1 (VSS), D13.1 (VSS), D14.1 (VSS), D15.1 (VSS), D16.1 (VSS), D17.1 (VSS), D18.1 (VSS), D19.1 (VSS), D20.1 (VSS), D21.1 (VSS), D22.1 (VSS), D23.1 (VSS), D24.1 (VSS), J16.3, J17.1, UI1.6 (Inh), UI1.7 (VEE), UI1.8 (VSS)
Hall1: J20.1, J21.2, UI1.13 (X)
Hall2: J20.2, J21.1, UI1.3 (Y)
HallOut1: J2.1, U1.2 (OUT), U9.2 (OUT), U17.2 (OUT), UI1.12 (X0)
HallOut2: J2.2, U2.2 (OUT), U10.2 (OUT), U18.2 (OUT), UI1.1 (Y0)
HallOut3: J3.1, U3.2 (OUT), U11.2 (OUT), U19.2 (OUT), UI1.14 (X1)
HallOut4: J3.2, U4.2 (OUT), U12.2 (OUT), U20.2 (OUT), UI1.5 (Y1)
HallOut5: J4.1, U5.2 (OUT), U13.2 (OUT), U21.2 (OUT), UI1.15 (X2)
HallOut6: J4.2, U6.2 (OUT), U14.2 (OUT), U22.2 (OUT), UI1.2 (Y2)
HallOut7: J5.1, U7.2 (OUT), U15.2 (OUT), U23.2 (OUT), UI1.11 (X3)
HallOut8: J5.2, U8.2 (OUT), U16.2 (OUT), U24.2 (OUT), UI1.4 (Y3)
LedIn: D1.2 (DIN), J10.2
LedOut: D24.4 (DOUT), J16.2, J17.2
unnamed: D1.4 (DOUT), D2.2 (DIN)
unnamed: D2.4 (DOUT), D3.2 (DIN)
unnamed: D3.4 (DOUT), D4.2 (DIN)
unnamed: D4.4 (DOUT), D5.2 (DIN)
unnamed: D5.4 (DOUT), D6.2 (DIN)
unnamed: D6.4 (DOUT), D7.2 (DIN)
unnamed: D7.4 (DOUT), D8.2 (DIN)
unnamed: D10.2 (DIN), D11.4 (DOUT)
unnamed: D9.2 (DIN), D10.4 (DOUT)
unnamed: D11.2 (DIN), D12.4 (DOUT)
unnamed: D12.2 (DIN), D13.4 (DOUT)
unnamed: D13.2 (DIN), D14.4 (DOUT)
unnamed: D14.2 (DIN), D15.4 (DOUT)
unnamed: D15.2 (DIN), D16.4 (DOUT)
unnamed: D8.4 (DOUT), D16.2 (DIN)
unnamed: D9.4 (DOUT), D17.2 (DIN)
unnamed: D17.4 (DOUT), D18.2 (DIN)
unnamed: D18.4 (DOUT), D19.2 (DIN)
unnamed: D19.4 (DOUT), D20.2 (DIN)
unnamed: D20.4 (DOUT), D21.2 (DIN)
unnamed: D21.4 (DOUT), D22.2 (DIN)
unnamed: D22.4 (DOUT), D23.2 (DIN)
unnamed: D23.4 (DOUT), D24.2 (DIN)
P: C1.1, C2.1, C3.1, C4.1, C5.1, C6.1, C7.1, C8.1, C9.1, C10.1, C11.1, C12.1, C13.1, C14.1, C15.1, C16.1, C17.1, C18.1, C19.1, C20.1, C21.1, C22.1, C23.1, C24.1, CI1.1, D1.3 (VDD), D2.3 (VDD), D3.3 (VDD), D4.3 (VDD), D5.3 (VDD), D6.3 (VDD), D7.3 (VDD), D8.3 (VDD), D9.3 (VDD), D10.3 (VDD), D11.3 (VDD), D12.3 (VDD), D13.3 (VDD), D14.3 (VDD), D15.3 (VDD), D16.3 (VDD), D17.3 (VDD), D18.3 (VDD), D19.3 (VDD), D20.3 (VDD), D21.3 (VDD), D22.3 (VDD), D23.3 (VDD), D24.3 (VDD), J16.1, J17.3, UI1.16 (VDD)
PQ1: J12.3, J13.1, U1.1 (VCC), U2.1 (VCC), U3.1 (VCC), U4.1 (VCC), U5.1 (VCC), U6.1 (VCC), U7.1 (VCC), U8.1 (VCC)
PQ2: J12.2, J13.2, U9.1 (VCC), U10.1 (VCC), U11.1 (VCC), U12.1 (VCC), U13.1 (VCC), U14.1 (VCC), U15.1 (VCC), U16.1 (VCC)
PQ3: J12.1, J13.3, U17.1 (VCC), U18.1 (VCC), U19.1 (VCC), U20.1 (VCC), U21.1 (VCC), U22.1 (VCC), U23.1 (VCC), U24.1 (VCC)
S0: J18.2, J19.1, UI1.10 (A)
S1: J18.1, J19.2, UI1.9 (B)
