shevapato2008/saiboard/(commit log)

2026-01-14 Update ESP32 main.c for 8x8 matrix mode, add documentation and AGENTS.md, and update .gitignore
2026-01-15 Add 8x8 matrix support to ESP32 firmware and document CAD/CAM file types
2026-01-16 conductor(setup): Add conductor setup files and initial track
2026-01-27 chore(electronics): update KiCad project files and add fabrication outputs
2026-01-31 Update 8x8 KiCad files: replace production zip and add backup from 2026-01-31
    [8x8.kicad_pcb]
2026-02-02 docs(hardware): expand guide with detailed step-by-step instructions and PCB tiling diagram
    - Section 1.1: Add board structure file list, materials, and 6-phase build steps
    (CNC cutting, wood glue-up, veneer, resin fill, poly finish, grid lines)
    - Section 1.2: Add PCB tiling layout, connector details, connection methods,
    installation diagram, purchase list, and 3 known design issues
    - Section 1.3: Add stones/molds file list, materials, and 4-phase build steps
    (3D print positive, silicone mold, resin casting with magnets, post-processing)
    - Add interactive SVG tiling diagram (current state + fix proposal)
    - Add CLAUDE.md project instructions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
    [3x8.kicad_pcb, 8x3.kicad_pcb]
2026-02-03 chore(electronics): add 8x8 PCB with GND copper pour and KiCad-to-LCEDA issue doc
    Add 8x8_filled variant with top/bottom GND copper pour for improved
    grounding. Document root cause analysis of KiCad-to-LCEDA conversion
    issues (PWR_FLAG network mapping errors causing short circuits).
    [8x8-B_Cu.gbr, 8x8-B_Mask.gbr, 8x8-B_Paste.gbr, 8x8-B_Silkscreen.gbr, 8x8-Edge_Cuts.gbr, 8x8-F_Cu.gbr, 8x8-F_Mask.gbr, 8x8-F_Paste.gbr]
2026-02-09 docs(hardware): expand guide with detailed instructions on 3D printing and resin casting for chess pieces
2026-02-12 chore(electronics): remove 8x8_filled PCB variant and update docs/KiCad projects
    Remove the 8x8_filled directory (GND copper pour variant) as it is no longer
    needed. Update hardware guide, PCB tiling diagram, and KiCad project files
    for 11x3 and 3x8 boards.
    [8x8-B_Cu.gbr, 8x8-B_Mask.gbr, 8x8-B_Paste.gbr, 8x8-B_Silkscreen.gbr, 8x8-Edge_Cuts.gbr, 8x8-F_Cu.gbr, 8x8-F_Mask.gbr, 8x8-F_Paste.gbr]
2026-02-25 feat(electronics): add 19x19 KiCad PCB and schematic generators
    - Fix capacitor footprint in generate_19x19.py: C_0402 → C_1206_3216Metric
    (matches sub-board convention)
    - Add generate_19x19_sch.py: generates saiboard_19x19.kicad_sch with 361
    SK6812 LEDs in serpentine layout, 361 decoupling caps, P/GND global labels,
    DOUT→DIN data chain wires, and J1/J2 connectors
    - Add generated saiboard_19x19.kicad_pcb (361 LEDs + 361 × C_1206 caps)
    - Add generated saiboard_19x19.kicad_sch (KiCad 6 format, ready to open)
    [saiboard_19x19.kicad_pcb, saiboard_19x19.kicad_sch]
2026-02-26 feat(electronics): add full routing, nets, vias, zones, connectors to 19x19 PCB generator
    - Rewrite generate_19x19.py: add netlist (GND/VDD/DIN_IN/DATA_1-361),
    collision-safe 3-case data-chain routing (1080 segments), 722 GND vias,
    full-board VDD/GND copper zones, J1/J2 connectors
    - Add export_gerbers.py: JLCPCB-ready Gerber (7 layers) + Excellon drill export
    - Zone fill skipped headless (KiCad 9 macOS ZONE_FILLER limitation);
    user fills zones in KiCad GUI with 'B' before Gerber export
2026-02-26 fix(electronics): remove SetExcludeEdgeLayer call removed in KiCad 9
2026-03-16 feat(esp32s3): diagonal LED strip mapping for 19x19 board
    Replace 3-section vertical serpentine LED mapping with anti-diagonal
    zigzag layout. Strip follows diagonals (d = row - col + 18) from
    [0,18] to [18,0], with 2 waste LEDs per turn (433 total, 361 active).
    Switch strip type from SK6812 (RGBW) to WS2812 (RGB). Restore full
    19x19 sensor matrix. Add mapping verification and reverse-lookup scripts.
    [led_mapping.py, led_reverse_mapping.py, main-old.c, main.c]
